jellebens/pomona/docs/sensors/level-sonic.md

# A02YYUW ultrasonic — tank level (Trello #270 / #283)

DFRobot SEN0311 (A02YYUW): a sealed ultrasonic distance sensor. Mounted
face-down above the reservoir, it measures the distance to the water surface;
the firmware turns that into litres. It is the **continuous** level gauge:
the CQRSENYW003 probe ([level-probe.md](level-probe.md)) stays the top-up
ladder and the pump interlock — nothing acts on the ultrasonic yet.

| | |
|---|---|
| Range | 30–4500 mm (blind below 30 mm: mount the face ≥ 3 cm above the FULL line) |
| Supply | 3.3–5 V — **use 3V3** (its TX swings to supply; the GIGA is not 5 V tolerant) |
| Output | UART 9600 8N1, frames `0xFF H L SUM`, distance = `H*256+L` mm, `SUM = (0xFF+H+L) & 0xFF` |
| Beam | ~ 40–60° cone: keep the tower column, the pump and the probe out of it |
| Firmware | `firmware/libraries/A02YYUW`, read in `src/sensors` since 2.4.0 |

## Wiring

| Sensor wire | GIGA |
|---|---|
| red (VCC) | **3V3** |
| black (GND) | GND |
| white (TX) | **D19 / RX1** (`Serial2`) |
| yellow (RX, mode) | **not connected** — floating = "processed value" output, the sensor streams on its own |

D0/D1 (`Serial1`) is not an option: the DS18B20 lives on D1. Don't confuse
the yellow wire with the DFR0523 pump pigtails ([../dosing/dfr0523.md](../dosing/dfr0523.md)).

## Bench check

After flashing, the tank tile shows the raw distance dimmed (`212mm`) and the
node publishes `ceres/pomona-0001/tele/water/level_distance_mm` every 30 s.
Hold a flat object at a measured distance: the value should agree to ±1 cm.
`--` on the tile = no valid frame for 3 s → check TX on D19 and 3V3/GND.

## Calibration (on the tower) — a measured fill table

The tank **tapers** (narrower at the bottom): a litre is ~12 mm of height near
the top and ~25 mm near the floor, so two points and a straight line are wrong.
Distance → litres is a table, `TANK_TABLE` in
`firmware/libraries/PomonaCalibration/src/PomonaCalibration.h`, interpolated
linearly between points and clamped at both ends (`libraries/A02YYUW/src/TankTable.h`).
The node publishes `level_pct` (of `TANK_FULL_L`) and `volume_l`, and the tile
shows litres, green ≥ 60 %, amber ≥ 30 %, red below.

To (re)measure it — after moving the sensor or changing the tank:

1. **Pump OFF** (`vertumnusctl.sh pomona-0001 pump off`) and keep it off. A
   Vertumnus restart puts it back on `auto`, so hold any ceres release meanwhile.
2. Drain the tank to a puddle; note the reading — that is 0 L.
3. Pour in **known volumes** — 0.5 L steps near the bottom, 1 L above — and
   after each wait for two equal `level_distance_mm` readings (≈ 1 min).
4. Put the pairs in `TANK_TABLE`, fullest first; set `TANK_FULL_L` to the
   volume you call full. Rebuild, roll out, put the pump back on `auto`.

**Only the sensor height changed?** Then the shape holds: read the distance at a
known volume and shift every point by the difference — that is how 2.4.2 got its table.

### Read between pump runs (2.4.6)

While the pump runs a litre or two is up in the tower and the surface is choppy (98–126 mm and
no-echo spikes at 9 L), and the tower drains back for minutes after a stop (8.74 L a minute after a
run, 9.0 L after half an hour). Since 2.4.6 the level is taken only once the pump has been off
5 min (`LEVEL_PUMP_SETTLE_MS`) and held through the next run (dropped after 45 min, then the live
reading): `level_distance_mm`, `level_pct` and `volume_l` are that value, `level_distance_live_mm`
is every sweep's raw median, `sys/health.level_held` says which. A dead sensor still reads absent
once the pump is off.

**Undone in 2.4.8 (2026-10-19).** The hold hid what the sensor saw: from 16 Oct ~23:30 it held
30 mm — the sensor's blind-zone floor, every frame `near`, zero good frames — for two and a half
days, through every pump run, and the reports showed a steady 9.00 L. The owner wants the real
readings, in the reports too. `level_distance_mm`, `level_pct` and `volume_l` are this sweep's
reading again, pump on or off; a run reads lower and choppier, and `tankJudge` still publishes no
litres for an unsteady surface. `level_distance_live_mm` stays (the same value) and
`sys/health.level_held` stays, always `false`, so no reader breaks.

### The table in force (2.4.10) — the sensor remounted 2026-10-19

The sensor was remounted with its two transducer bosses clear of the lid (they must not touch the
plastic). With exactly **10 L** in the tank it read **36 mm**, pump off and settled, on 2026-10-20.
Before that fill it read ~88 mm, and the owner had poured in "almost 4 L", so ~6.1 L = 88 mm.

- **10 L to 6.1 L:** a straight line between those two points, ~13 mm per litre. That matches the
  2026-10-09 fill near the top of the tapered tank.
- **Below 6.1 L:** the 2026-10-09 shape, shifted −33 mm. Verify it once with a known volume when
  the tank runs low.
- **Full is 10 L again**, 6 mm clear of the 30 mm floor (where 2.4.9 says `near`).

| L in tank | 0 | 0.5 | 1.0 | 1.5 | 2.0 | 2.5 | 3.0 | 3.5 | 4.0 | 4.5 | 5.5 | 6.1 | 7.0 | 8.0 | 9.0 | 10.0 |
|---|---|---|---|---|---|---|---|---|---|---|---|---|---|---|---|---|
| mm | 251 | 230 | 218 | 204 | 188 | 176 | 159 | 138 | 124 | 116 | 95 | 88 | 76 | 63 | 49 | 36 |

Since annona 0.12.0 (ceres ADR-0022) Ceres records the settled pump-off `volume_l` as the unit's
reservoir volume, so this table is now what the doses are sized for.

### The table of 2.4.5 — the sensor remounted 2026-10-16

New holes in the lid (two transducers 34.0 mm apart, M3 holes 72.6 mm apart: DFRobot's
drawing). Measured pump off with known volumes: 5.5 L = 110 mm, 7.5 L = 66, 8.0 L = 56,
9.0 L = 37 — a straight ~20 mm per litre. Below 5.5 L the 2026-10-09 shape, shifted −18 mm
(to be verified). 10 L would be inside the blind zone at this mount, so the top of the table is
**9.0 L**: do not fill above ~9 L, or raise the sensor.

| L in tank | 0 | 0.5 | 1.0 | 1.5 | 2.0 | 2.5 | 3.0 | 3.5 | 4.0 | 4.5 | 5.5 | 7.5 | 8.0 | 9.0 |
|---|---|---|---|---|---|---|---|---|---|---|---|---|---|---|
| mm | 266 | 245 | 233 | 219 | 203 | 191 | 174 | 153 | 139 | 131 | 110 | 66 | 56 | 37 |

The old mount's readings were wrong (87 mm at ~5 L — it heard something before the water), so
the 2.4.2 table below describes that mount only.

### The table of 2.4.2 — lid closed, the old mount

Full is **10 L at 76 mm** (a steady reading 2026-10-09 22:50–22:55, lid closed,
pump off) — 46 mm clear of the 30 mm blind zone. Annona's `reservoir_l` is 10.

| L in tank | 0 | 0.5 | 1.0 | 1.5 | 2.0 | 2.5 | 3.0 | 3.5 | 4.0 | 4.5 | 5.5 | 6.5 | 9.5 | 10 |
|---|---|---|---|---|---|---|---|---|---|---|---|---|---|---|
| mm | 284 | 263 | 251 | 237 | 221 | 209 | 192 | 171 | 157 | 149 | 128 | 116 | 82 | 76 |

**Read it with the pump off.** While the pump runs the sensor reads ~37–47 mm
at a full tank — the water falling back from the tower crosses the beam — so a
reading taken mid-cycle says "full" whatever the level.

### The fill it comes from — 2026-10-09 21:56–22:14 CEST, sensor 36 mm lower

| L in tank | 0 | 0.5 | 1.0 | 1.5 | 2.0 | 2.5 | 3.0 | 3.5 | 4.0 | 4.5 | 5.5 | 6.5 | 9.5 |
|---|---|---|---|---|---|---|---|---|---|---|---|---|---|
| mm | 248 | 227 | 215 | 201 | 185 | 173 | 156 | 135 | 121 | 113 | 92 | 80 | 46 |

6.5 → 9.5 L was a single 3 L pour, so the top of the curve is one straight
segment. 2.4.1 shipped this fill as is (full 9.5 L at 46 mm); with the lid
closed the face sits 36 mm higher.

## The blind zone and a silent sensor

Closer than 30 mm the sensor cannot measure. Since 2.4.2 a valid frame of
1–29 mm counts as 30 mm, i.e. **full** — the tank is never silent for being
too full. A frame of **0 mm** means "no echo" and stays invalid: that is what a
**tilted** sensor sends (2026-10-09 22:15–22:42: knocked during a pour, the
node published nothing). `sys/health.level_sonic_frames` tells the cases apart
remotely: `bad` climbing = no echo / garbage (tilted, obstructed), `near`
climbing = water at the face, nothing climbing = no frames (wiring, power).

**Since 2.4.9 the floor is not "full".** At the 2.4.5 mount FULL (9.0 L) is 37 mm, so a sensor
pinned at 30 mm — 2026-10-16..19, every frame `near`, zero good, two and a half days — passed as
`ok` and reported 9.00 L. A reading at the 30 mm floor (most of the window's frames in the blind
zone) is now `level_sonic_state` = `near`: `level_distance_mm` = 30, no litres.

## What is not the surface (2.4.3)

Since 2.4.3 a reading becomes litres only when it is plausibly the water surface and steady
(`tankJudge` in `TankTable.h`); otherwise the node publishes no `level_pct` / `volume_l` and says
why in `sys/health.level_sonic_state`:

| state | reading | what it was on the tower |
|---|---|---|
| `splash` | nearer than FULL (76 mm) by more than 15 mm, blind-zone frames included until 2.4.9 (now `near`) | the return water falling past the sensor during a pump run (33–53 mm, read as "10 L" by 2.4.2), foam |
| `no_echo` | farther than EMPTY (284 mm) by more than 15 + 5 = 20 mm | a **wet face** — condensation over 25 °C water after the move indoors read 240–720 mm (2.4.2: "0 L" for a day) |
| `unsteady` | the last 6 sweeps (30 s) disagree by more than 15 mm, or fewer than 6 yet | a face drying or wetting; the first 30 s after boot |
| `near` (2.4.9) | at the 30 mm blind-zone floor — most frames closer than the sensor can measure; checked first | 2026-10-16..19: every frame `near`, zero good, for 2.5 days — 2.4.8 and earlier called it `ok`, 9.00 L |
| `ok` | everything else; the table still clamps the last few mm at either end | with the pump running and a dry face: 86–87 mm = 9.06 L |

Keep the face dry and out of the return stream: mount it where nothing falls past it, give it a drip
edge, let the headspace breathe. The raw `level_distance_mm` is still published every cycle.

## The double echo

Over a flat surface the pulse can bounce water → sensor face → water and come
back at **twice the distance**: on the tower 320–355 mm for a 160–175 mm
surface, often enough to win a plain median (2.4.0 then read a well-filled tank
as nearly empty). Since 2.4.1 the driver drops every frame within 10 % of twice
another frame in its 15-frame window. Damping the mount helps too: a flat lid
right around the face reflects best — mount the face flush, or ring it with a
little foam or felt.
