jellebens/pomona/docs/seeding/README.md

# Seeding

Per-crop sowing and germination docs, plus the shared method. The 30-pod
target layout and nutrient targets live in
[../planting-plan.md](../planting-plan.md).

> **✅ Strawberry SOWN 2026-08-03 — 12 sponges, ~5 seeds each.** The full
> strawberry quantity went in, superseding the 3-sponge PoC allocation. See
> [strawberry.md](strawberry.md) for the as-built record and the dated
> timeline: germination 17 Aug – 2 Sept, 3-week count ≈24 Aug, transplant ≈14–28 Sept.
>
> **✅ BOTH CROPS GERMINATED 2026-08-07** — lettuce and strawberry, from an
> early-August sowing. The strawberries came up on **day 4** against a 14–30
> day book figure; the 28 °C ambient that looked like a problem accelerated
> them. See [lettuce.md](lettuce.md) and [strawberry.md](strawberry.md).
>
> **❌ The lettuce then DIED** (reported 2026-08-31, exact date unrecorded).
> First real failure in the project. Diagnose before re-sowing — and check the
> strawberries, which shared the tray and survived it: post-mortem in
> [lettuce.md](lettuce.md).
>
> **⏰ The strawberry transplant window is OPEN NOW** (≈31 Aug – 14 Sept;
> sown 08-03, so they are ~4 weeks old). Gate on the plants: roots through the
> sponge + 3–4 true leaves. They are the first crop into the tower; re-sown
> lettuce follows ~3 weeks after it goes back in.
>
> **⚠ Both deadlines are now due or past.** The reservoir must be dosed
> before anything is transplanted (EC 0.8–1.0, pH → ~6.0) — **pH-Down was
> deliberately deferred by the owner** on the #254 shopping list until the pen
> reads above 6.5, so check the pen before dosing rather than assuming a buy is
> needed. The **grow light was due end of August** and matters immediately:
> seedlings that raced up in a hot room stretch just as fast in weak light.
> [poc.md](poc.md) is superseded for strawberry; its hardware/software exit
> criteria now have an August deadline, not a September one.

## Per-crop docs

**All seed is bought and on hand** — nothing is waiting on a purchase.

| Crop | Doc | Sowing status |
|---|---|---|
| Strawberry (alpine 'Rote Baron Solemacher') | [strawberry.md](strawberry.md) | **✅ GERMINATED 2026-08-07** (day 4!) — sown 08-03, 12 sponges × ~5 seeds |
| Peppers (paprika, Dulce Italiano, chili) | _to write_ | **sow now — warm tray 25–28 °C** |
| Parsley | _to write_ | **soak seed now, sow a day later** — cool tray |
| Lettuce (iceberg) | [lettuce.md](lettuce.md) | **❌ DIED** (reported 2026-08-31) — diagnose, then re-sow into a clean tray |
| Basil | _to write_ | sow in ~1 week — fast, would outgrow the cohort |
| Dill | _to write_ | sow in ~1 week — fast, and hates root disturbance later |

Full sowing schedule with dates and spare counts: Trello #219, comment
"Seedling plan (2026-08-03)" + checklist "Seedling schedule".

## Per-crop sowing table

**All seed is now bought and on hand.** Sponge counts are overplanted so the
strongest can be thinned to the pod count in brackets.

| Crop | Sponges (→ pods) | Seeds/sponge | How to sow | Tray temp | Germination |
|---|---|---|---|---|---|
| Paprika | 4 → 3 | 2 | in the hole, ~5 mm deep | **25–28 °C** | 7–14 d |
| Dulce Italiano | 4 → 3 | 2 | in the hole, ~5 mm deep | **25–28 °C** | 7–14 d |
| Chili | 2 → 1 | 2 | in the hole, ~5 mm deep | **25–30 °C** | 7–21 d |
| Parsley | 4 → 3 | 3–4 | in the hole, shallow. **Soak seed 12–24 h first** | 18–24 °C | 14–28 d |
| Basil | 7 → 5 | 3–4 | shallow, barely covered | 20–25 °C | 5–10 d |
| Dill | 2 → 1 | 3–4 | shallow, barely covered | 15–21 °C | 10–14 d |
| Lettuce | 3 → 4 pods by succession | 2–3 | **surface or barely covered** — light-favoured | 15–20 °C, **poor above 24** | 2–7 d |
| Strawberry | 12 → 10 | ~5 | **surface, uncovered** — Lichtkeimer | 20–24 °C | 14–30 d |

Thin peppers and chili to the single strongest seedling per sponge; basil,
parsley and dill may keep 2–3 stems.

### ⚠ Two trays, not one — the temperatures do not overlap

Peppers want **25–28 °C** while lettuce fails above ~24 °C and strawberry
sits at 20–24 °C. One tray cannot serve both:

- **Warm tray (25–28 °C):** paprika, Dulce Italiano, chili. Top of the
  fridge, near a radiator, or a heat mat. These are buried seed, so this tray
  does *not* need light until they sprout — but it must not dry out.
- **Cool tray (20–22 °C, bright indirect light):** strawberry (already
  running), lettuce, parsley, later basil and dill. This is the tray that
  must never go dark.

Dill at 15–21 °C is the odd one out; the cool tray's lower end suits it well
enough.

### ⚠ Hot weather (ambient ≈28 °C) — what it helps and what it breaks

Recorded 2026-08-03, ambient **28 °C**. This is not a neutral condition:

**Helps.** The warm tray needs no heat mat at all — 28 °C sits right in the
pepper/chili band. Sow peppers on the worktop and be done.

**Breaks.** There is no cool tray at 28 °C ambient, and three things need one:

| Crop | Wants | At 28 °C |
|---|---|---|
| Lettuce | 15–20 °C, poor above 24 | Thermodormancy above ~27 °C in theory — **but this seed lot germinated fine at 28 °C on 2026-08-03.** Variety and lot dependent; test rather than assume. |
| Strawberry | 20–24 °C | Textbook says germination falls off above ~25 °C. **In practice this batch germinated on day 4 at 28 °C** — heat accelerated it. The remaining risk is total germination *rate* and stretched seedlings, not a stalled tray. |
| Dill | 15–21 °C | Too warm; patchy. |
| Parsley | 18–24 °C | Warm, and it is already the most erratic germinator in the plan. |
| Basil | 20–25 °C | Fine — basil is heat-tolerant and germinates fast at 25–28 °C. |

**What to do:**

1. **Move the strawberry tray to the coolest spot available** — cellar,
   north-facing room, tiled floor, lowest shelf. This matters most: 12
   sponges of slow seed are already committed. Check it is not near a sunny
   window; a domed tray in 28 °C ambient with sun on it can exceed 35 °C,
   which is lethal rather than merely slow.
2. **Ventilate daily, without fail.** Heat plus a sealed humid dome is ideal
   damping-off and algae weather.
3. **Dill: hold until it cools**, or fridge-prime the seed (soak 12–24 h,
   then 24–48 h in the fridge before sowing). *Lettuce turned out not to need
   this — it germinated at 28 °C anyway on 2026-08-03. Tolerance varies by
   variety and seed lot, so try a couple of sponges before assuming the heat
   will stop it.*
4. **Peppers and chili: sow now**, ambient is ideal.
5. If nothing cooler than ~26 °C exists in the house, accept slower and
   patchier strawberry germination and treat the fridge reserve seed as the
   real backup, re-sown when the weather breaks.

### Sowing order now that everything is on hand

- **Sow now:** peppers and chili — longest lead after strawberry, every week
  of delay pushes fruiting deeper into winter, and at 28 °C ambient they need
  no heat source.
- **Hold until it cools (or fridge-prime):** dill. Lettuce is already up —
  see [lettuce.md](lettuce.md) — and gets re-sown on succession every 2–3
  weeks from here.
- **Parsley:** soak the seed 12–24 h and sow into the coolest spot available,
  or hold it with the lettuce if nothing is below ~26 °C.
- **Sow in ~1 week:** basil. It germinates in 5–10 days (and is happy at
  28 °C), so sowing it alongside the peppers would leave it transplant-ready
  long before the rest of the cohort and leggy while it waits.

## Shared method — starter sponges

Starter medium is **grow sponges** for every crop (decided 2026-08-03).
Sponges are inert and pH-neutral, so unlike rockwool they need no acid
pre-conditioning — and their surface stays evenly damp, which is what
surface-sown light germinators need. Rockwool was considered and dropped:
it is alkaline (pH ~7.5–8, needs a pH 5.5 pre-soak), its top crusts dry, and
a wet lit rockwool surface algaes up.

**Sponge shape:** cross-cut into four wedges, gaping when dry and closing as
it swells when wet. Soak before sowing, then sow on the **wedge top faces**,
not down the slit — fine seed dropped into the cut is lost in the dark. The
same four wedges grip the seedling stem at transplant. See
[strawberry.md](strawberry.md) for the placement and pipette techniques.

1. **Prep:** dunk in plain demin water, squeeze under water a few times to
   expel air, let absorb fully, drain. No pH correction of the soak water.
2. **Damp, not saturated.** **2–3 mm of plain demin water** in the tray only,
   no nutrients yet; waterlogged sponges rot seed and invite damping-off.
3. **Sow** into the pre-made hole for normal seed — **except light
   germinators, which go on the surface uncovered** (see
   [strawberry.md](strawberry.md)).
4. **Dome for humidity, but do not use a dark cupboard.** Light germinators
   (strawberry, and lettuce prefers it) must have light on the seed from day
   one; only buried-seed crops are indifferent to it. Bright *indirect* light
   is the safe default for a shared tray — direct midday sun through glass
   cooks a domed tray.
5. Keep exposed sponge tops shaded once under light; permanently wet
   surfaces grow algae.
6. At first true leaves, tray-feed **quarter-strength A+B, pH ~5.8**. Demin
   water has no buffering, so the nutrient solution holds the pH.
7. **Transplant gate:** roots through the sponge + true leaves (2 for most
   crops, 3–4 for strawberry). Move the **whole sponge** into the net pod;
   it must not sit in standing water.

## Why slowest-first

The principle behind the order above: stagger sowing by germination speed so
the whole cohort reaches transplant size together, instead of the fast crops
going leggy in the tray while the slow ones are still bare sponge.

1. **Strawberry — ✅ done 2026-08-03** (12 sponges). 14–30 d germination,
   6–8 weeks to transplant size; slowest by a wide margin now that it is
   seed-grown rather than plugs, which is why it led.
2. **Peppers, chili, parsley: 7–28 d** — the longest lead after strawberry.
   Every week of delay pushes their fruiting further into winter.
3. **Basil, dill, lettuce: 2–14 d** — fastest, so they go last. Lettuce then
   turns over continuously; re-sow a couple of sponges every 2–3 weeks.

Dates key off the **actual strawberry sow date, 2026-08-03** (recorded on
Trello #219).

## Reservoir state gate

Nothing is transplanted while the reservoir holds plain demineralised water
(EC ~0, unbuffered). Dose A+B to **EC 0.8–1.0** for young transplants,
correct pH to **~6.0** with the PH-201H pen, then plant. Ramp to the shared
**EC 1.4–1.6** over 2–3 weeks as the fruiters go in.
