jellebens/pomona/docs/planting-plan.md

# Planting plan — 30-pod layout, nutrients, commissioning

Status: final. Crops and the 30-pod layout were owner-decided **2026-07-29**
(Trello #219), all-edible — the flower trial (chamomile, lavender) was cut
and the pods reallocated. Revised **2026-08-03**: **lettuce ×4 added (seed on
hand)**, trimming dill and chili by one pod each. Strawberry keeps its 10
pods.

**Tomato is out of the plan entirely (owner, 2026-08-03).** The tros (vine)
tomato added earlier that day was dropped, and with the cherry tomato already
replaced there is now **no tomato in the tower**. Its 2 pods went back to
basil and parsley. Reasons it went: indeterminate at 1.5–2 m with heavy
trusses, it would have shaded the tiers above and dominated reservoir draw in
a 25×25×86 cm tower on 10 L; it also demanded EC 2.0–3.0 against lettuce's
0.8–1.2 on a single shared reservoir. If tomato is ever wanted back, the
tower-appropriate choice is a **dwarf/determinate cherry** (Tiny Tim / Red
Robin) ×2 — seed would need buying — or better, a truss variety in its own
separate bucket with its own solution.

## ✅ AS-BUILT — first transplant, 2026-08-31

**18 of 30 pods planted.** The tower is live for the first time.

| Tier | Planned | **As-built** |
|---|---|---|
| 6 (top) | Dill ×1 · Basil ×2 · Strawberry ×2 | *empty* |
| 5 | Parsley ×3 · Lettuce ×2 | *empty* |
| 4 | Basil ×2 · Strawberry ×3 | **Strawberry ×4** |
| 3 | Strawberry ×5 | **Strawberry ×5** |
| 2 | Dulce Italiano ×3 · Chili ×1 · Lettuce ×1 | **Dulce Italiano ×3 · Chili ×2** |
| 1 (bottom) | Basil ×1 · Lettuce ×1 · Paprika ×3 | **Paprika ×4** |

**As-built totals (18):** strawberry 9 · paprika 4 · Dulce Italiano 3 · chili 2

**Deltas from plan:** paprika +1, chili +1, strawberry −1 (9 of 10 survived to
planting). Basil, parsley, dill and lettuce are **not in the tower** — the
lettuce died in the tray and the herbs were not sown in time. Tiers 5 and 6
stay empty for them.

The heavy-fruiter-low principle held: peppers occupy tiers 1–2, strawberries
sit mid-tower at picking height. Losing the tier-6 strawberries is no loss —
keeping all nine together on tiers 3–4 is tidier to net and to pick.

### ⚠ The EC plan changed the moment the peppers went in

Earlier guidance said to run **EC ~1.2 while the tower is strawberry-only**.
That no longer applies: it was never strawberry-only. Nine peppers and chilis
(which want ~1.8–2.4) went in beside nine strawberries (1.2–1.6) on day one,
so the tower is mixed from the start and the shared **1.4–1.6** compromise is
the right target.

**But not yet.** These are freshly transplanted young plants: start at
**EC 0.8–1.0, pH ~6.0** and ramp to 1.4–1.6 over the following 2–3 weeks as
they establish.

### Immediate follow-ups

- [ ] **Confirm the reservoir is actually dosed.** If it is still plain
      demineralised water, the plants are sitting at EC ~0 with no buffering
      and will stall. This is the first thing to check.
- [ ] **Blank off the 12 empty pods** with their plugs — cuts evaporation and
      keeps light off the water, which keeps algae down.
- [ ] **Check every strawberry crown sits proud** of its sponge and clear of
      any pebbles. A buried crown rots.
- [ ] **Confirm the drip reaches tiers 1–4.** A dry tier is easy to miss.
- [ ] **Pinch strawberry flowers for 2–3 weeks** to force root and crown
      growth. On the peppers, pinching the first king flower likewise helps
      them bulk up before fruiting.
- [ ] Shade from harsh direct sun for the first 2–3 days.
- [ ] **Capture sensor baselines** — the telemetry stack went live the same
      day (#222), so this is the natural moment to record what a freshly
      planted, freshly dosed tower reads.
- [ ] Sow basil, parsley and dill, and re-sow lettuce into a clean tray, for
      tiers 5 and 6.

## Layout

Hocomay tower, 6 tiers × 5 pods. Tier 1 = bottom.

| Tier | Pods |
|---|---|
| 6 (top) | Dill ×1 · Basil ×2 · Strawberry ×2 |
| 5 | Parsley ×3 · Lettuce ×2 |
| 4 | Basil ×2 · Strawberry ×3 |
| 3 | Strawberry ×5 |
| 2 | Dulce Italiano ×3 · Chili ×1 · Lettuce ×1 |
| 1 (bottom) | Basil ×1 · Lettuce ×1 · Paprika ×3 |

**Totals (30):** strawberry 10 · basil 5 · lettuce 4 · paprika 3 ·
Dulce Italiano 3 · parsley 3 · chili 1 · dill 1

The 2 pods freed by dropping the tomato went to **basil (4→5)** and
**parsley (2→3)** — the two highest-turnover kitchen herbs, both genuinely
cut-and-come-again. Chili and dill stay at 1 each on purpose: one plant of
either out-produces what a household gets through.

Strawberry placement (tier 3 ×5, tier 4 ×3, tier 6 ×2) is unchanged and
matches [seeding/strawberry.md](seeding/strawberry.md).

### Placement rationale

- **Heavy fruiters low (tiers 1–2):** paprika, Dulce Italiano and chili sit
  at the bottom for stability and can be staked from the floor. They will
  crowd sideways as they bulk up — prune/train outward.
- **Strawberries mid + top:** fruit cascades clear of the tower at picking
  height.
- **Cut-and-come-again herbs (tiers 4–5):** basil, parsley.
- **Tall/airy on top (tier 6):** dill needs the headroom.
- **No tomato.** With the tros variety dropped, nothing in the tower now
  exceeds ~40 cm except the dill, so no tier gets shaded out and no plant
  needs external staking or weekly side-shooting.
- **Lettuce is the turnover crop:** ~30–45 days pod-to-plate. Re-sow a
  couple of sponges every 2–3 weeks and the 4 lettuce pods rotate
  continuously.

## Nutrients — one shared reservoir

Single 10 L reservoir → one compromise mix for all crops:

- **EC: 1.4–1.6 mS/cm** — lowered from 1.6–1.8 now that the tomato is gone.
  The truss tomato was the only crop wanting 2.0–3.0 and it was dragging the
  compromise up against lettuce (0.8–1.2) and strawberry (1.2–1.6). Without
  it the heaviest feeders are the peppers (~1.8–2.4), so a **1.4–1.6** middle
  sits much closer to every crop's real optimum.
- **pH: 5.8–6.2, set point ~6.0**

~~While the tower is strawberry-only, run EC ~1.2.~~ **Void — the tower was
never strawberry-only.** Peppers and strawberries went in together on
2026-08-31, so 1.4–1.6 is the target from the start; see the as-built section
above for the establishment ramp (0.8–1.0 first, then up over 2–3 weeks).

Per-crop ideal hydro pH, all covered by the 5.8–6.2 window:

| Crop | Ideal pH |
|---|---|
| Strawberry (alpine) | 5.5–6.2 |
| Paprika / Dulce Italiano / chili | 5.8–6.3 |
| Basil / parsley / dill | 5.5–6.5 |
| Lettuce | 5.5–6.0 |

## Commissioning sequence

State 2026-07-27: reservoir holds **7.5 L plain demineralised water** — EC ~0,
unbuffered pH. Demin water is unbuffered, so pH readings before nutrients go
in are meaningless (they drift).

1. Add A+B nutrients (on hand). Target **EC 0.8–1.0** for the first young
   transplants, not the full 1.4–1.6 — that comes later as plants mature.
2. Measure pH with the PH-201H pen (nutrients buffer the water, readings now
   stable). Later the SEN0169-V2 probe provides continuous readings.
3. Correct toward pH 6.0 with pH-Down/Up (to buy).
4. Germinate seeds in starter sponges; transplant into pods once roots show
   through the sponge. See [seeding/](seeding/README.md).
5. Strawberries are **seed-grown alpines** ('Rote Baron Solemacher', on
   hand) — sown first because they are the slowest crop, and they make the
   grow light mandatory by mid-September. See
   [seeding/strawberry.md](seeding/strawberry.md).

## Seeding

Sowing and germination now live in **[seeding/](seeding/README.md)** — the
shared sponge method, sowing order, and per-crop docs. Start with
[seeding/strawberry.md](seeding/strawberry.md).

Full sowing schedule (two batches, spare counts, transplant gate) is on
Trello #219 — comment "Seedling plan (2026-08-03)" + checklist "Seedling
schedule".

## Seeds & supplies (shopping list, checklist lives on Trello #219)

- ~~Cherry tomato~~ / ~~tros tomato~~ — **no tomato in the plan**, nothing to
  buy or sow (owner dropped it 2026-08-03)
- ~~Salad~~ — **seed on hand**: lettuce, 4 plants (succession re-sow)
- ✅ Paprika — compact/snack mini bell, 3 plants
- ✅ Sweet pepper 'Dulce Italiano', 3 plants
- ✅ Chili — compact variety (Apache / rawit), 1 plant
- ~~Strawberry plugs~~ — **not needed, seed on hand**: alpine 'Rote Baron
  Solemacher' (*Fragaria vesca* var. *semperflorens*), 10 plants
- ✅ Basil — Genovese, 5 plants
- ✅ Parsley — flat-leaf (Gigante d'Italia), 3 plants
- ✅ Dill, 1 plant
- ✅ Starter medium: grow sponges (on hand)

**All seed is bought (2026-08-03) — nothing is waiting on a purchase.** The
remaining outstanding items are the #220 hardware ones below.
- Already tracked on #220: pH-Down/Up, EC cal fluid 1413 µS/cm, grow light,
  Fibaro plug

## Ops notes

- 7 fruiting plants on 10 L → expect near-daily top-ups once mature in
  summer; the water-level sensor (#220) makes this visible. Dropping the two
  truss tomatoes takes a real bite out of peak reservoir draw — they would
  have been the thirstiest plants in the tower by a wide margin.
- Top up with plain (demin) water between full nutrient changes; re-dose by
  EC reading.
- Lettuce at the shared EC 1.4–1.6 still risks some **tip burn** — harvest
  heads young and keep airflow over the tower. Less of a problem than at
  1.6–1.8, but the one-reservoir compromise has not vanished.
