jellebens/pomona/docs/seeding/strawberry.md

# Seeding — strawberry (alpine, 'Rote Baron Solemacher')

Status: active plan, 2026-08-03. Owner has **seed**, not plugs — this
supersedes the "buy day-neutral plugs" line in
[../planting-plan.md](../planting-plan.md).

## What the variety is, and why it matters

Packet: **Erdbeere 'Rote Baron Solemacher'** =
*Fragaria vesca* var. *semperflorens* — an **alpine / wild strawberry**
(German *Monatserdbeere*), not a garden strawberry. Consequences, all good
for a tower:

| Trait | Effect here |
|---|---|
| **Lichtkeimer** (light germinator) | Seed must lie **on** the surface — burying it stops germination. This is the single most important step below. |
| Germination needs **>20 °C** | Warm spot required; it is slow and erratic even then (~14–30 days). |
| **Runnerless** | No runners to dangle, root into neighbouring pods, or prune. Ideal in a 30-pod tower. |
| **Everbearing**, fruits in its **first year** | Unlike garden strawberry from seed (~a year to fruit), this cropped from summer to autumn in year one. |
| Compact, **15–20 cm** | Fits any tier; no staking. |
| Small, intensely aromatic fruit | Flavour is the payoff, not volume — expect a handful at a time across 10 plants, not bowls. |

Grows true from seed, so saving seed later is viable.

## Sowing

**Sow strawberries FIRST.** With plugs they would have been the instant
crop; from seed they are now the *slowest* thing in the plan, so they lead
rather than follow the pepper/basil batches.

### ✅ SOWN 2026-08-03 — 12 sponges, ~5 seeds each

**As-built, not a plan.** The owner sowed the **full main quantity — 12
sponges × ~5 seeds ≈ 60 seeds** — rather than the 3 sponges the PoC allotted.
The 5-sponge PoC ([poc.md](poc.md)) is therefore **superseded for strawberry**;
its hardware/software exit criteria still stand and now carry a real deadline
(see the timeline below), but the "prove it on 15 seeds first" hedge is spent.

What this changes:

- **No top-up wave is expected.** At ~5 seeds per sponge nearly every sponge
  yields a plant, so 12 sponges should comfortably fill the 10 pods with 2
  spares. Only re-sow if the 3-week count comes in low (below).
- **More seed is committed to one technique.** If the surface-sowing or the
  light/moisture regime is wrong, ~60 seeds are at risk instead of 15. The
  mitigation is the fridge reserve, below.
- **Sow 2 lettuce sponges now anyway.** Lettuce is up in 2–7 days versus
  14–30 for strawberry, so it is the early-warning signal on tray moisture,
  temperature and light — three weeks before the strawberries would reveal a
  problem. That is worth more now, not less, with 60 seeds committed.

### Reserve and the 3-week count

- **Put the rest of the packet in the fridge**, damp in a sealed bag. Cold
  stratification for 2–4 weeks costs nothing, lifts and evens out *F. vesca*
  germination, and is now the entire fallback if this sowing disappoints.
- **Count germinating sponges at ~3 weeks (≈24 Aug):**
  - **8 or more** → the 10 pods are covered. Keep the reserve seed for next
    season.
  - **4–7** → sow ~6 stratified sponges to top up.
  - **under 4** → something went wrong (surface dried out, seed fell into the
    cuts, too cold, too dark, mould). Diagnose before re-sowing — do not
    simply repeat it with the reserve.

**Only 10 pods are reserved for strawberry**, which is why 12 sponges is the
right number and 20 would have been waste: at ~5 seeds each, nearly every
sponge produces a plant.

Seed germinates patchily (40–60% is normal), which is why sponges are
overplanted rather than pods.

⚠ A deliberate later wave has a cost: sown three weeks behind, those plants
transplant three weeks deeper into the dark season and will likely wait until
spring to fruit. That is fine for insurance, but it is not a free succession
crop.

### Method — sponges, surface-sown

1. Soak the sponges in plain demin water, squeezing under water to expel
   air. Drain; **damp, not dripping**.
2. **Sow on the quadrant faces — avoid the hole and the cuts.** The sponge
   has a **small central hole with four cuts running radially out from it**,
   so the top is four quadrant faces around a little bore. The hole and cuts
   are for the seedling stem and its roots at transplant, *not* for sowing:
   dust-fine seed dropped in falls into the dark and will not germinate.

   Soak the sponge first — wet sponge swells and the cuts close up — then
   place each seed on a **quadrant face, ~5 mm out from the central hole**,
   and press it down with a fingertip just enough to make contact. Spread the
   4–6 seeds of a position across different quadrants. **Cover them with
   nothing at all** — they need light.

   *Placing seed this fine by hand is fiddly. Easiest method, using the 3 ml
   pipettes already on the shopping list: tip the seed into a few ml of
   water, stir, draw it up, and dispense one drop per spot. The drop carries
   the seed and leaves it sitting wet at the surface — standard practice for
   dust-fine light germinators. A damp toothpick works too, one seed at a
   time.*

3. **Never germinate this crop in the dark.** The instinct to put a seed tray
   in a warm dark cupboard is right for most seed and *wrong* here — a
   Lichtkeimer needs light on the seed to trigger germination at all. Dome or
   cover the tray (clear lid, bag, cling film) to hold humidity, but keep it
   in **bright indirect light**: a north/east windowsill, or beside a
   south-facing window rather than in its beam. Avoid direct midday sun
   through glass while domed — that cooks the tray.
4. Hold **20–24 °C** (20–22 °C if lettuce shares the tray). **2–3 mm of plain
   demin water in the tray** — no nutrients until the first true leaves.
   Never let the sponge tops dry out, since surface-sown seed has no moisture
   reserve.

   ⚠ **Too warm is a real failure mode, not just slower.** Above ~25 °C
   germination falls off; a domed tray in a hot room with sun on it can pass
   35 °C and cook the seed. Ambient was **28 °C** when this batch was sown
   (2026-08-03), so the tray belongs in the coolest spot available — cellar,
   north room, tiled floor — and must be ventilated daily against
   damping-off. See the hot weather section in
   [README.md](README.md).
5. Ventilate briefly each day to keep mould and damping-off away.
6. **Expect 14–30 days**, uneven. Do not give up on a tray at three weeks.

### After germination

- Seedlings start minuscule — two rounded seed leaves, and they stay tiny for
  a while even after a fast start. Patience is normal here, not a fault.
- **Vent the dome progressively, never all at once.** Alpine seedlings this
  small dry out within hours if the humidity drops off a cliff. Crack it open,
  widen the gap over several days, and only then remove it. This is the
  opposite of the lettuce, which wants the dome off promptly.
- **⚠ Damping-off is now the main risk**, not germination. Fast warm
  germination means a hot, humid, crowded tray full of hair-thin stems, which
  is exactly the condition that kills seedlings overnight at soil level. Daily
  ventilation is not optional, and standing water in the tray must stay at
  2–3 mm rather than creeping up.
- **Light matters more than it did an hour ago.** Seedlings that raced up in
  warmth will stretch just as fast in weak light, and a stretched alpine
  seedling stays weak. Brightest indirect spot available.
- At first true leaves, begin **A+B at quarter strength, EC 0.4–0.8, pH
  ~5.8**. Alpine seedlings burn easily; err lean.
- Thin to the single strongest seedling per position once they have 2 true
  leaves — scissors at the base, not fingers.

## Transplant into the tower

**Gate:** roots showing through the sponge **and** 3–4 true leaves. Normally
6–8 weeks from sowing, but germination ran ~10 days ahead of book, so the
window pulls back to **≈31 August – 14 September**. Gate on the plant, not the
date — a fast start does not guarantee the rest keeps pace.

1. Reservoir first: 7.5 L demin → A+B to **EC 0.8–1.0** (half strength for
   young plants) → measure with the PH-201H pen → pH-Down to **~6.0**.
   Never pot into plain demin water.
2. Transplant the **whole sponge** into the net pod — do not tease apart the
   roots.
3. **Crown above the medium.** Where leaf meets root must stay dry and in
   open air; a buried crown rots. Wedge with clay pebbles if the pod is
   loose.
4. Placement per the layout: **tier 3 ×5, tier 4 ×3, tier 6 ×2.**
5. Pinch off every flower for the first 2–3 weeks after transplant to force
   root and crown growth. It costs a few early berries and repays them.
6. Step EC up toward the shared **1.4–1.6** only once the peppers join
   (there is no tomato in the plan). While the tower is strawberry-only, run
   **~1.2** — alpines sulk at high EC.

## ⚠ The lettuce in this tray died (reported 2026-08-31)

These strawberries shared the tray and the conditions and have survived it —
which is reassuring but not proof of safety, since damping-off spreads. Treat
them as exposed: ventilate hard, strip out every dead seedling and any
mould or algae, replace the tray water, move to the coolest and brightest spot
available, and **check the stem bases daily rather than the leaves** —
damping-off shows at the base and kills within a day once it starts. Full
differential diagnosis in [lettuce.md](lettuce.md).

## Transplant day — runbook

Do these in order. Steps 1–3 happen **before a single plant is touched.**

### 1. Thin first, on the bench

One plant per pod. If a sponge still carries 2+ seedlings, snip the weaker
ones off **at the base with scissors** — pulling drags the keeper roots out
with them. Do this before transplanting, not after: two seedlings sharing one
net pod compete and both stay small.

Discard any sponge whose seedling is leggy and floppy rather than merely
small — a stretched alpine seedling does not recover, and it takes a pod that
a good one could have.

**How many stems to leave (owner decision, 2026-08-31):**

| Stems in the sponge | Do |
|---|---|
| **1** | Plant it as is. |
| **2** | Acceptable to leave. Alpines are small and runnerless, so a pod carries two better than a pepper would — but plan to snip one within 2–3 weeks once it is clear which established. |
| **3+** | **Thin now**, down to one or two. |

Leaving extras is not free. They share one pod worth of drip and root volume,
so both plants end up smaller and each yields less fruit; and the denser
foliage cuts airflow inside the tower, which is exactly the condition that
favours botrytis and damping-off — the most likely thing that killed the
lettuce.

**Better insurance than crowding a pod:** there are 12 sponges for 10 pods.
Keep the two extras going in the tray as replacements instead of doubling up
plants in a pod. A spare on the bench costs nothing; a crowded pod costs yield
all season.

Whatever the count, **snip at the base — never pull.**

### 2. Dose the reservoir — nothing goes in before this

Plain demin water is EC ~0 and unbuffered; roots stall in it.

1. 7.5 L demin → A+B to **EC 0.8–1.0** (half strength; these are young
   plants, and alpines burn easily).
2. Stir, let it settle, then read pH with the **PH-201H pen**.
3. Target **~6.0** (window 5.8–6.2). **pH-Down was deliberately deferred** on
   the #254 shopping list until the pen reads above 6.5 — so measure before
   assuming a correction is needed. If it does read high and there is no
   pH-Down in the house, that is a hard stop: transplanting into
   out-of-range solution is worse than waiting a day.
4. Cross-check the dosed reservoir against the in-tank EC/pH sensors while you
   are there. Transplant day is the natural moment to capture a baseline with
   known-good hand readings beside the live ones.

### 3. Prove the plumbing

Run the pump and confirm water actually reaches **the top tier**. A tier that
is not being dripped is easy to miss and fatal to whatever is planted in it.
Check every tier you intend to use.

### 4. Transplant

1. Move the **whole sponge** into the net pod. **The seedling never leaves the
   sponge** — do not pull it out, do not rinse it off, do not tease the roots
   apart. The sponge is now part of the plant and stays with it for life.
2. **Seat it, do not squeeze it.** A firm press to settle it home is fine;
   compressing or jamming it in is not. Squeezing collapses the sponge
   structure, drives the air out, and it then stays waterlogged — the same
   mistake as wringing one out by hand. Aim for snug.
   - **Sponge loose in the cup?** Pack clay pebbles around the outside to
     wedge it. Do not stuff extra sponge in beside it.
   - **Sponge too big?** Do not force it. Pare a sliver off the outside edge
     with a knife, well clear of the roots.
3. **Feed the roots down through the cup, not back up inside it.** Any roots
   already out of the sponge bottom go through the net slots so they hang free
   into the tower interior. Roots folded back up into the cup will circle and
   choke.
4. **Crown above the medium** — the point where leaf meets root must stay dry
   and in open air, proud of the sponge and clear of any pebbles. A buried
   crown rots, and this is the single most common way to kill a hydroponic
   strawberry.
5. Placement per the layout: **tier 3 ×5, tier 4 ×3, tier 6 ×2**. With fewer
   survivors, fill tier 3 first (best light, fruit hangs clear), then tier 4.
6. Blank off unused pods with their plugs — it cuts evaporation and keeps
   light off the water, which keeps algae down.

### 5. First week

- Keep them out of harsh direct sun for the first 2–3 days while roots take.
- Check daily that every planted tier is still being dripped.
- Top up with **plain demin water** as the level drops, then re-check EC —
  evaporation concentrates the solution, top-ups dilute it.
- **Pinch off every flower for the first 2–3 weeks.** It feels wrong and it is
  the highest-return thing you can do: it forces root and crown growth and
  pays back in far more fruit later.
- **EC:** start at 0.8–1.0 for freshly transplanted plants and ramp to the
  shared **1.4–1.6** over 2–3 weeks. (The old "hold ~1.2 while
  strawberry-only" advice is void — the peppers went in the same day.)

## Timeline — as-built

Sown **2026-08-03**. **✅ Germinated 2026-08-07 — day 4.**

That is dramatically ahead of the 14–30 day figure this doc predicted, and
worth understanding rather than just celebrating: the 28 °C ambient that the
hot-weather section flagged as a *problem* almost certainly caused it. Warmth
accelerates germination; the risk it carries is a lower total germination rate
and leggier seedlings, not a slower start. So the speed is real, but expect
the sponge count to matter (below) and watch for stretching.

| When | What |
|---|---|
| ~~17 Aug – 2 Sept~~ | ~~Germination window (14–30 d)~~ — **superseded, it germinated on day 4** |
| **now** | **Count sprouted sponges out of 12** — this replaces the ≈24 Aug 3-week count. 8+ → no top-up, keep the reserve seed. Under 4 → the fast warm germination came at the cost of rate; sow stratified reserve in a cooler spot. |
| **≈14–21 Aug** | First true leaves → start quarter-strength A+B (EC 0.4–0.8, pH ~5.8); thin to one seedling per sponge at 2 true leaves. |
| **by ≈25 Aug** | **pH-Down and EC calibration fluid must be in hand** — strawberry-driven now that the lettuce died. |
| **≈31 Aug – 14 Sept** | Transplant window, pulled ~2 weeks earlier by the fast germination (3–4 true leaves, roots through the sponge). Gate on the plant, not the date. |
| **by end Aug** | **Grow light running** — pulled forward from mid-Sept. Seedlings that came up on day 4 are growing *now*, in a hot room, and August daylight indoors is already marginal for stopping them stretching. |
| Sept onward | First flowers; pinch them for the first 2–3 weeks after transplant. |

### ⚠ Purchase deadline — pH-Down, ~14 August

The transplant gate requires a **dosed** reservoir: A+B to EC 0.8–1.0, then
pH corrected to ~6.0. **pH-Down/Up and the EC calibration fluid (1413 µS/cm)
are still unbought** (#220), and without pH-Down there is no way to bring a
freshly dosed reservoir to 6.0.

The binding date is set by the **lettuce**, which transplants first (see
[lettuce.md](lettuce.md)) — but the strawberries' fast germination has now
pulled their own window back to ≈31 Aug – 14 Sept, so both crops want the
reservoir live in the second half of August. **~14 August, and it is the most
time-critical item in the project.**

### ⚠ Light is on the critical path

These seedlings hit their growth phase in September–October as Belgian
daylight collapses, and they will try to flower into it. With plugs the grow
light (#220) was a nice-to-have; **from seed it is required.**

**The deadline moved forward to ~end of August.** It was mid-September, keyed
to a mid-September transplant. Two things changed it: germination ran ~10 days
early, so the plants are growing *now*, and they are doing it in a 28 °C room
where weak light produces stretched, permanently weak seedlings within days.
Waiting until the original date risks arriving with a tray of leggy plants and
no fruit until spring — the light is needed for the seedling phase, not just
for the tower.

Sources: [magicgardenseeds.de — Erdbeere 'Rote Baron Solemacher'](https://www.magicgardenseeds.de/Erdbeere-Rote-Baron-Solemacher-Fragaria-vesca-var-semperflorens-Samen),
[samenhaus.de — Monatserdbeeren Rügen Baron von Solemacher](https://www.samenhaus.de/monatserdbeeren-ruegen-baron-von-solemacher-erdbeersamen-von-buzzy-seeds/a-544686),
[gardenseedsmarket.com — Alpine strawberry 'Baron Solemacher'](https://gardenseedsmarket.com/alpine-strawberry-baron-solemacher-seeds-fragaria-vesca.html)
