jellebens/pomona/CHANGELOG.md

# Changelog

All notable changes to the Pomona project are documented here.
Format: [Keep a Changelog](https://keepachangelog.com/); versions are the
firmware semver from `firmware/libraries/PomonaVersion` (single source of
truth, bumped by the deploy scripts). Tags `v<version>` mark each release
merged to `master`.

## [2.4.0] - 2026-10-09

### Added
- the tank level from the A02YYUW ultrasonic (#270 / #283)
- the credential gate — check secrets.h against the running image before any build

### Other
- 2.4.0 — the tank level from the A02YYUW ultrasonic (#283); changelog

## [Unreleased]

## [2.4.10] - 2026-10-20

### Changed — the tank table for the remounted sensor (#283)
- The A02YYUW was remounted on 2026-10-19 with its two transducer bosses clear of the lid. The
  2.4.5 table no longer fit: with exactly 10 L in the tank it read 36 mm, which that table called
  9.0 L. The new `TANK_TABLE` comes from the owner's fill of 2026-10-20, pump off and settled:
  - before the fill, ~88 mm;
  - "almost 4 L" poured in;
  - then 10 L = 36 mm.
- Between 10 L and ~6.1 L the table is a straight line, ~13 mm per litre. That is what the
  2026-10-09 fill measured near the top, where the tank is widest. Below 6.1 L the 2026-10-09
  shape is shifted −33 mm to meet 88 mm.
- 10 L is FULL again, clear of the 30 mm blind-zone floor.
- Points (mm → L): 36→10, 49→9, 63→8, 76→7, 88→6.1, 95→5.5, 116→4.5, 124→4, 138→3.5, 159→3,
  176→2.5, 188→2, 204→1.5, 218→1, 230→0.5, 251→0.

## [2.4.9] - 2026-10-19

### Changed — a sensor pinned at its blind-zone floor says `near` (#283)
- A tank reading at or under the A02YYUW's 30 mm floor (the median of its frames; a frame inside
  the blind zone reads as 30 mm) is now judged `near` by `tankJudge`: `sys/health.level_sonic_state`
  = `near`, `level_distance_mm` still publishes the raw value, and no `level_pct` / `volume_l` —
  the same as `no_echo`. At the 2.4.5 mount FULL (9.0 L) is 37 mm, within the 15 mm splash margin
  of the floor, so a pinned sensor passed as `ok`: 2026-10-16..19 every frame was `near` (zero good)
  and the node reported 30 mm / 9.00 L for two and a half days. The tile shows `near`.

## [2.4.8] - 2026-10-19

### Changed — the tank level is live again (#283)
- Undoes 2.4.6's level hold. `level_distance_mm`, `level_pct` and `volume_l` are each sweep's
  reading again, pump on or off, so MQTT, Prometheus and the dashboards show what the sensor reads
  (owner: "I want to see the real readings also in the reports"). The hold had shown a steady
  30 mm / 9.00 L for two and a half days while every A02YYUW frame was `near` (the blind-zone floor,
  zero good frames). A pump run reads lower and choppier; `tankJudge` still publishes no litres for
  an unsteady surface. `level_distance_live_mm` (now the same value) and `sys/health.level_held`
  (always `false`) stay, so no reader breaks. The EC hold (2.4.4) is unchanged.

## [2.4.7] - 2026-10-16

### Changed — after a boot the pump runs first
- The duty cycle started in its OFF phase at every boot, so a reboot added a whole off spell
  (15 min in establishment, 45 by day / 105 at night established) to the downtime itself: two OTAs
  within 14 min on 2026-10-16 left the pump off from 13:58 to ~14:27. Every boot (an update, a power
  cut, a crash) now starts the cycle with a run (`PUMP_ON_MS`), then the normal off spell. The pump
  is still off through setup, and the level interlock and an operator override still take
  precedence. Erring wet is recoverable, erring dry is not. Credential gate passed against
  `build-2.4.6`.

## [2.4.6] - 2026-10-16

### Changed — the tank level is read between pump runs (#283)
- While the pump runs a litre or two is up in the tower and the surface is choppy (98–126 mm and
  no-echo spikes at 9 L), and it drains back for minutes after a stop (8.74 L a minute after a run,
  9.0 L after half an hour). The level (`level_distance_mm`, `level_pct`, `volume_l`) is now taken
  only once the pump has been off 5 min and held through the next run (the same hold as EC's,
  `src/sensors/ec_hold.h`; dropped after 45 min). A steady line that only falls as the plants drink.
- New `tele/water/level_distance_live_mm`: every sweep's raw median. `sys/health.level_held` says
  whether the level is a held value. Credential gate passed against `build-2.4.5`.

## [2.4.5] - 2026-10-16

### Changed — the tank table for the remounted sensor (#283)
- The old mount heard something before the water: a steady 87 mm (9.06 L on the 2.4.2 table)
  while the tank held a little more than 5 L. The sensor was remounted (new holes, DFRobot's
  34.0 / 72.6 mm pattern) and measured pump off with known volumes: 5.5 L = 110 mm, 7.5 L = 66,
  8.0 L = 56, 9.0 L = 37 (~20 mm per litre). The table's top is those points; below 5.5 L the
  2026-10-09 shape is kept, shifted −18 mm (to verify once at a known low volume). At this mount
  10 L would be inside the 30 mm blind zone, so 9.0 L is the top of the table ("9 L or more").
  Credential gate passed against `build-2.4.4`.

## [2.4.4] - 2026-10-16

### Changed — EC is read between pump runs (ceres ADR-0020)
- The EC probe reads the pump: with the pump running the un-isolated TDS board reads high
  (2026-10-06/07: 1.43 off → 1.81 on; 2026-10-15/16: 1.63 off → 1.96 on), the step within seconds
  of each switch; pH, behind its DFR0504 isolator, is unaffected. Ceres 0.28.0 refuses to act on
  an EC whose pump states disagree, so EC control had stopped (0.29.0 alerts `ec_untrusted`).
- Until the EC probe gets an isolator, `tele/water/ec_ms_cm` is measured only with the pump OFF
  for 2 min (`EC_PUMP_SETTLE_MS`) and that value is held through the run and the settle after it
  (`src/sensors/ec_hold.h`); a hold older than 45 min (`EC_HOLD_MAX_MS` — an override, a long mix)
  is dropped for the live reading, and the live reading is used until the first pump-off value
  after a boot. The screen shows the same value.
- New `tele/water/ec_live_ms_cm`: this sweep's reading, pump on or off — the pump's effect stays
  visible in the archive. `sys/health.ec_held` says whether the published EC is a held value.
- Host-tested on the 2026-10-15/16 pattern (15 min on at 1.95 / 15 off at 1.63): only 1.63 is
  published after the first pump-off spell. 752,404 B flash (38 %), 26 % RAM; credential gate passed
  against `build-2.4.3`.

## [2.4.3] - 2026-10-11

### Fixed — a tank reading is litres only when it is the water surface (#283)
- 2.4.2 clamped every distance to the fill table's ends, so readings the sensor could not mean became
  confident numbers. On the tower: the return water falling past the sensor during a pump run read
  33–53 mm → **"10 L"**; a wet face (condensation over 25 °C water since the tower moved indoors) read
  240–720 mm, jumping minute to minute → **"0 L" from 2026-10-10 ~15:00 for over a day**, while the tank
  held ~9 L (the owner's figure with the pump running; the dry sensor read 86–87 mm = 9.06 L).
- `tankJudge` (`TankTable.h`) now classifies each reading: **splash** (nearer than FULL by > 15 mm — the
  tank cannot fill past its full mark; this includes the blind-zone frames 2.4.2 read as full),
  **no_echo** (farther than EMPTY by > 20 mm — the floor is 284 mm away), **unsteady** (the last 6 sweeps,
  30 s, disagree by > 15 mm, or fewer than 6 yet), else **ok**. Only `ok` publishes `level_pct` /
  `volume_l`; the raw `level_distance_mm` is still published always (calibration aid).
- `sys/health` gains `level_sonic_state` (`ok|splash|no_echo|unsteady|absent|uncalibrated`);
  `level_sonic_calibrated` now means "the fill table is set" (2.4.2: table set AND sensor answering).
  The screen's tank tile shows the state word instead of a litre figure it cannot vouch for.
- Host-tested against the tower's own readings (87 mm → ok 9.06 L; 38 → splash; 30 → splash;
  391/651 → no_echo; jumping 120 → unsteady). 752,140 B flash (38 %), 26 % RAM; credential gate passed
  against `build-2.4.2`.

## [2.4.2] - 2026-10-09

### Fixed — the tank table for the lid-closed mount; the blind zone reads full; frame counters (#283)
- 2.4.1's table was read with the sensor lower than its final place. With the lid closed, 10 L reads a steady
  76 mm (pump off), so the table is shifted +36 mm (shape unchanged: 10 L at 76 mm … 0 L at 284 mm, 14 points)
  and **full is 10 L** again — 46 mm clear of the 30 mm blind zone. `UNIT_RESERVOIR_L` back to 10.
- Known: while the pump runs the sensor reads ~37–47 mm at a full tank (the return water crosses the beam), i.e.
  "full" mid-cycle; read the level with the pump off. Not filtered yet.
- **The blind zone reads as full** instead of going silent: a valid frame of 1–29 mm counts as 30 mm (→ 10 L,
  100 %). A frame of 0 mm stays "no echo" — what a tilted sensor sends — so a knocked sensor never reads full.
  On 2026-10-09 22:15–22:42 the sensor sat tilted after the last pour and the node published nothing.
- `sys/health` gains `level_sonic_frames: {good, near, bad}`, the driver's counters since boot, so a silent
  sensor's cause shows remotely: `bad` climbing = garbage / no echo (tilted), `near` = water at the face, none
  climbing = no frames at all (wiring, power).
- Fixed in the driver on the way: a valid "no echo" frame's checksum byte is 0xFF, which the resync took for a
  new header and lost the next frame; resync now only follows a checksum failure.

## [2.4.1] - 2026-10-09

### Changed — the tank level in litres from a measured fill table; double echoes dropped (#283)
- The tank **tapers**, so the two-point line of 2.4.0 is replaced by a distance → litres table measured on the
  tower on 2026-10-09 (0 L at 248 mm … 9.5 L at 46 mm, 13 points): `TANK_TABLE` / `TANK_FULL_L` in
  `PomonaCalibration.h`, interpolated linearly and clamped (`libraries/A02YYUW/src/TankTable.h`).
  `TANK_DIST_FULL_MM` / `TANK_DIST_EMPTY_MM` are gone. The node now publishes `level_pct` and `volume_l`.
- **Full is 9.5 L** (10 L would sit ~40 mm from the face, near the 30 mm blind zone): `level_pct` is a share of
  9.5 L and `UNIT_RESERVOIR_L` in `sys/meta` is 9.5 (Annona's `reservoir_l` was set to 9.5 the same night).
- **Double echo:** the sensor often reported twice the true distance (320–355 mm over a 160–175 mm surface — the
  pulse bouncing water → face → water), enough to win the median. The driver now drops every frame within 10 %
  (min 10 mm) of twice another frame in its window, and the window grows from 7 to 15 frames (~2–3 s) so a
  direct frame is there to unmask them.
- Host-tested: an echo-dominated window (6 echoes, 3 direct) reads the water; the table's points, midpoints and
  clamps. `docs/sensors/level-sonic.md`: the fill-table procedure, the recorded table, the echo.

## [2.4.0] - 2026-10-09

### Added — the tank level from the A02YYUW ultrasonic (#270 / #283)
- New library `firmware/libraries/A02YYUW`: a non-blocking parser of the sensor's 9600-baud
  `0xFF H L SUM` frames (checksum, 30–4500 mm range, resync after a bad frame) that reports the
  median of the last 7 good frames, or -1 after 3 s without one. `sensorsPoll()` drains the UART every
  `loop()`; the sensor is on `Serial2` (TX → D19), powered from 3V3, its RX wire floating.
- Calibration `TANK_DIST_FULL_MM` / `TANK_DIST_EMPTY_MM` in `PomonaCalibration.h` (NAN until read on
  the tower — procedure in `docs/sensors/level-sonic.md`). Volume is linear between the two.
- MQTT: `tele/water/level_distance_mm` always when the sensor answers; once calibrated
  `tele/water/level_pct` (now the ultrasonic's — the Grove strip only fills it when no calibrated
  ultrasonic exists) and `tele/water/volume_l`. `sys/health` gains `level_sonic` and
  `level_sonic_calibrated`; `sys/meta.sensors` lists `level_sonic`.
- Screen: the tank tile is live — litres, green from 60 %, amber from 30 %, red below; before
  calibration the raw distance (`212mm`, dimmed) so the calibration session can read it off the tower.
- The level probe still drives the pump interlock; nothing acts on the ultrasonic yet.
- Ceres: vertumnus 0.27.0 subscribes the three topics and exports them as `ceres_reading{metric}`.

### Added — the credential gate of the release flow
- `.claude/scripts/check-secrets.sh <running.bin> [secrets.h]`: checks that `WIFI_PASS` and
  `MQTT_PASS` from `secrets.h` are embedded in the binary of the image the node runs now — the
  passwords it last connected with. Prints only "matches" / "NOT in" and the length, never a value;
  exit 0 = build, 1 = mismatch or placeholder, 2 = cannot check. The `pomona-release` runbook makes
  it Phase 3, step 0 (a failure is a STOP: the owner supplies the right `secrets.h`), and says to
  keep `~/ota-tools/build-<ver>/` of every flashed image as the next gate's reference.
- Why: 2.3.2 (2026-10-09) was built from a stale `secrets.h`; the node flashed, then the broker
  refused it, and with the OTA trigger MQTT-only no corrected image could reach it — recovery took a
  power cycle and an owner-approved broker password change. The gate fails that build
  (against `build-2.3.1`: exit 1).

## [2.3.2] - 2026-10-09

### Fixed — NTP is retried until it answers
- The photoperiod needs wall-clock time, and the node asked NTP once at connect and
  then every 6 h — **also after a failed attempt**. With no clock the light is held
  off (the safe failure), so one lost packet at boot meant up to 6 h of a dark tower.
  It happened on 2026-10-09: the tower was moved indoors, rebooted twice
  (12:41 and 12:56 CEST), missed its one attempt and held the light off from
  12:41 — the 6 h retry would have come at ~19:00, an hour before lights-out.
- A failed attempt is now retried after `NTP_RETRY_MS` (60 s), alternating
  `NTP_HOST` (`pool.ntp.org`) and `NTP_HOST_FALLBACK` (`time.cloudflare.com`), until
  one answers; the 6 h resync applies only after a success. Each attempt stays
  bounded by `NTP_TIMEOUT_MS` (1.2 s), well inside the 30 s watchdog. The pump never
  consulted the clock and still does not.
- Compiles clean for `arduino:mbed_giga:giga`: 750,340 B flash (38 %), 138,848 B RAM (26 %).

## [2.3.1] - 2026-09-17 (on the tower since 2026-09-17 01:12; released to `master` with 2.3.2)

### Changed — the node bounds one request, not the day (owner 2026-09-16, ceres card #315)
- `DOSE_MAX_ML_PER_CMD` pH-Down 2.0 → 4.0 ml (`config.h`); a regular dose is
  about 2 ml, so one command can carry a double. A/B stay at 10 ml.
- The rolling 24 h budget is gone: `DOSE_MAX_ML_PER_24H`, the per-channel dose
  ring and the `over 24h cap` refusal are removed (`dosing.cpp`), and `sys/meta`
  no longer announces `max_ml_per_24h`. How much goes in per day is the
  controller's decision — Ceres removed its own daily cap on 2026-09-11 (ADR-0004).
- Why: 2.3.0 carried the retired playbook caps ("twice Ceres's derived acid
  cap"), so from the moment it went live (2026-09-15 17:01) the node refused every
  2.7 ml and 4.8 ml request with `over per-command cap 2.0 ml` and the tank
  drifted to pH 8.5 in a day. The Vertumnus side (reading `max_ml_per_cmd` from
  `sys/meta`, its gitops rail lowered to 4.0 ml) is ceres card #315.
- Still enforced per request: the reagent must be known and calibrated, one
  channel at a time, the absolute 60 s run cap, the 10 s bench cap.

### Added — `firmware/tools/lzss_ota.py`, the `.ota` packager
- Compresses an exported `.bin` the way the library's `LZSSDecoder` expects
  (Okumura LZSS, EI 11 / EJ 4, space-filled window) and writes the Portenta
  OTA header (length, CRC-32, magic `0x23410266`, version word). With `--ref`
  it validates itself against a previously served image first: the 2.3.0 image
  decodes to a 758,392 B binary and re-encodes to the identical 604,590 B
  payload. Recipe in `firmware/pomona/README.md` ("Building the `.ota` image").

## [2.3.0] - 2026-09-15

### Changed — the home screen (PR #102)
- Six tiles in two rows of three replace the nine-tile grid: water temp, EC and pH
  on top; air temp, humidity and a dimmed "tank level" placeholder below. Pressure,
  lux, the Grove level % and the probe status word leave the screen (still published
  on MQTT; the probe still drives the pump interlock). The placeholder waits for the
  continuous level sensor (#270 / #283). Unused `setInt()` removed so the build stays
  warning-free. Compiles clean for `arduino:mbed_giga:giga` (arduino-cli 1.5.1):
  750,468 B flash (38 %), 139,872 B RAM (26 %). Not flashed: the 2.x line (2.0.0 →
  2.3.0) goes to the tower together, in the maintenance window of ceres card #295 item 7.

## [2.2.0] - 2026-09-13

### Added — the ack echoes the request's trace context
- A `dose/request` may carry a W3C `traceparent` (Vertumnus 0.13.0 puts it in
  while a trace is live). Every `dose/result` for that request — a refusal at
  request time or the `done` when the run ends — echoes the value unchanged, so
  one Jaeger trace spans decision → broker → node → ack → judgement (ceres
  ADR-0008 addendum). Opaque string, never parsed; requests without it produce
  the 2.1.0 acks byte for byte. The event buffer grows 224 → 320 bytes so an ack
  with the 55-char value never truncates.

## [2.1.0] - 2026-09-12

### Changed — the topic root is `ceres/`
- Demeter is Ceres (ceres ADR-0012: one pantheon, Roman only). Every v2 topic
  is `ceres/pomona-0001/…`; the controller is Vertumnus (`vertumnus-pomona-0001`),
  the config service Annona. Nothing else changes; 2.0.0 was never on the tower.

## [2.0.0] - 2026-09-12

### Changed — BREAKING: the v2 wire (demeter ADR-0008)
- Every topic moves to `demeter/pomona-0001/…`: `tele/<zone>/<metric>`
  (+ `tele/node/rssi_dbm|uptime_s`), `sys/status` (LWT), `sys/health`,
  `sys/diag/i2c_scan[/get]`, `sys/ota/url|result`, `actuator/pump/state|reason`,
  `actuator/light/state`, `actuator/pump/set`, `desired`. The unit connects as
  its own broker user `unit-pomona-0001` (client id the same). `docs/mqtt.md`
  rewritten; the v1 tree is history the archive keeps.
- `sys/meta` (retained, on connect): the node's self-description — type,
  node, fw_version, contract 2, sensors, actuators, reservoir_l, and every
  doser's calibration + caps.

### Added
- **The #224 dosing contract:** `dose/request` `{id, reagent, ml, rate}` is
  converted with the node's OWN calibration (`PomonaCalibration.h` `DOSER_CAL`)
  and checked against the node's OWN rails (`config.h`: per-command ml caps,
  rolling 24 h ml caps, one channel at a time, 60 s absolute run cap); every
  request is acked on `dose/result` `{id, status: done|refused|failed, ml, ms,
  channel, reason, ts}`. A bench run (USB Serial `dose chN …` only — the MQTT
  bench topic is gone) acks without an id.
- `actuator/light/set` (`auto|on|off`): a human override of the photoperiod
  (#263 wanted it for testability); resets to `auto` at boot.
- `desired.stage` replaces `control/mode` as the establishment/established
  switch (Demeter's registry publishes the document).
- A tiny flat-JSON reader (`src/util/json.h`) for the two documents the node reads.

### Docs
- `docs/mqtt.md` is the node's view of ADR-0008; `docs/control-architecture.md`
  topic names; the sketch README.

## [1.3.8] - 2026-09-10

### Fixed
- pH recalibration post-Cat5e - anchors 1.529/2.074 V

### Docs
- v1.3.7 release notes (automated)

## [1.3.7] - 2026-09-10

### Fixed
- EC recalibration post-Cat5e - K 0.9745 -> 0.7692

### Docs
- v1.3.6 release notes (automated)

## [1.3.6] - 2026-09-10

### Fixed
- EC signal on A2 per perm wiring (was A0)

### Docs
- 2026-09-09 recalibration on final wiring + tube runs
- v1.3.5 release notes (automated)

## [1.3.5] - 2026-09-09

### Fixed
- pin map as-landed by owner - ch1 pH=D6, ch2 A=D4, ch3 B=D5
- move pump signals back to bench-proven D4-D7 block

### Docs
- v1.3.4 release notes (automated)

## [1.3.4] - 2026-09-09

### Fixed
- pH-Down = D13, spare = D12 — verified at the panel

### Docs
- v1.3.3 release notes (automated)

### Other
- v1.3.4

## [1.3.3] - 2026-09-09

### Added
- OTA screen force-awake + tagged serial logs

### Fixed
- ch1 pH-Down = D12, spare = D13 (owner correction)

### Docs
- ch3 slow-speed constant 0.20 ml/s (#286)
- ch2 + ch3 commissioned and calibrated (#285, #286)
- DFR0523 as-built — ch1 commissioned + calibrated (#284)
- v1.3.2 release notes (automated)

### Other
- v1.3.3
- OneWire moves to D1 (perm wiring)
- final wiring pin map — ch1 D13, ch2 D10, ch3 D11, ch4 D12

## [1.3.2] - 2026-09-04

### Added
- serial debug commands for the bench session

### Fixed
- use DFRobot GravityPump reference pulse values

### Docs
- v1.3.1 release notes (automated)

### Other
- v1.3.2

## [1.3.1] - 2026-09-03

### Fixed
- generate PPM with mbed PwmOut — Servo lib holds the pin high on GIGA

### Docs
- v1.3.0 release notes (automated)

### Other
- v1.3.1

## [1.3.0] - 2026-09-03

### Added
- bench-test module for the DFR0523 channels (#284)

### Docs
- v1.2.0 release notes (automated)

### Other
- v1.3.0

## [1.2.0] - 2026-09-03

### Added
- band color coding on all metric tiles
- water level tile follows the 2026-09-01 level semantics

### Other
- v1.2.0
- auto-update CHANGELOG.md on every release tag

## [1.1.0] - 2026-08-31

The #260 control feature: the GIGA becomes the thing that decides when the
pump and light run, publishing its decisions as requests that Home Assistant
relays onto the Fibaro plugs. Delivered over the air the same evening
(compile 728 KB / 37%, OTA verified: `fw_version 1.1.0`, first requests
published with reason `boot_safe` → `schedule`). Until the HA-side cutover
switch (`input_boolean.pomona_firmware_control`) is turned on, the firmware's
requests are advisory only and HA's own schedule keeps driving the plugs.

### Added
- **Local pump + light control module (#260)** — duty cycle on `millis()`
  alone (15/15 establishment, 15/45 established day, 15/105 established
  night), so a unit with no network still waters correctly; NTP photoperiod
  (08:00–20:00 establishment, 06:00–20:00 established) with lights held OFF
  when there is no clock (off is the safe failure); level interlock with the
  5-min settle check, hourly rate limit, 24 h confirmed-low inhibit, and
  fail-open on unknown. Priority: interlock → override → schedule — an
  override can never outrun the interlock's veto.
- **Control topics** — retained QoS 1 `pomona/pump/request`,
  `pomona/light/request`, `pomona/pump/reason`, republished on every
  connect; subscribes `pomona/pump/override` + `pomona/control/mode`.
  Decisions publish on change, not on the 30 s metric cadence.
- `controlInit()` runs first in `setup()` — a rebooting unit reaches a known
  pump/light intent before anything that can hang.

### Docs
- Control architecture decision (where the logic lives) + `docs/mqtt.md`
  control-topic contract; level-probe mount is permanent (raw 0 mid-cycle
  is not trustworthy); planting-plan as-built (first transplant, 18/30
  pods); seeding notes (pod seating, stems per pod); lettuce post-mortem
  and transplant runbook.

## [1.0.0] - 2026-08-28

Assembly week's finale: the tower unit is built (#254) and **every v1
sensor is connected, reading, and calibrated** — water temp, EC, pH,
level probe, air (BME280), and light (BH1750) — with v1.0.0 itself
delivered over the air. Versions 0.1.13 → 1.0.0 were built and deployed
one at a time during the bench sessions (one commit per deployed version).

### Added
- **Remote I²C diagnostics** — retained `pomona/unit/i2c_scan` each
  publish cycle plus an on-demand trigger (`pomona/unit/i2c_scan/get`),
  so a headless unit's wiring is checkable over MQTT.
- **Boot screen** — name, version, build date, live I²C scan result, and
  a step-by-step boot progression (sensors → I²C → WiFi → MQTT). Tap the
  Pomona header any time for the same info screen with a fresh scan.
- **OTA progress screen** — stages (downloading/decompressing/installing/
  rebooting), a live countdown, and a *do not power off* warning; failed
  updates show their reason, then restore the readings.
- **Water level tile as OK / WRN / CRIT** (≥3 / 1–2 / 0 probe points, in
  green/amber/red).
- Raw pH voltage published (`pomona/water/ph_raw_v`) — recalibration is
  doable remotely from now on.

### Fixed
- **Same-version OTA replay guard** — the broker replays queued `ota_url`
  messages on reconnect; a URL naming the running version is now skipped
  (a stale trigger once kept re-installing 0.1.13 in a loop).
- **Wedged-I²C-bus boot-loop immunity** — a miswired run holding SDA/SCL
  low made the scans outlive the watchdog; stuck pins are now detected
  before first I²C use, skipped, and named on the boot screen.
- Full-screen views no longer inherit the tiles' flex layout (clipped
  titles, unreachable tap-to-return on the info and update screens).
- Sensor availability flags drop honestly when a flaky cable kills reads
  after a good init (no more stale `bme280: true`).
- BME280 accepted at 0x76 **or** 0x77 — the unstrapped default is fine
  now that the Grove level strip (which owned 0x77) is retired.

### Calibrated
- **EC**: `EC_CAL_K = 0.9745` — stable 1.45 mS/cm in 1413 µS/cm fluid at
  25.6 °C (20 ml in a narrow vessel suffices; ~8 min settle).
- **pH**: two-point 1.56 V @ 7.00 / 2.10 V @ 4.00 (slope −5.56 pH/V),
  **validated** against the 10.01 buffer (read 1.00 V vs 1.02 V
  predicted). Buffer anchors are configurable constants; the probe's
  wet-up drift lesson is recorded in `docs/sensors/ph.md`.

## [0.1.12] - 2026-08-27

OTA release — over-the-air updates work end-to-end and untethered:
v0.1.11 (wired serial watch) and v0.1.12 (no cable at all, owner-confirmed
on screen) were both delivered via MQTT trigger → HTTP download →
bootloader apply. The unit no longer needs USB for firmware updates.

### Fixed
- **OTA download size verification + retry** (#243, PR #35) — the mbed
  core's `download()` returns the HTTP Content-Length while its file writes
  go unchecked, so a truncated file surfaced later as
  `decompress failed (-5)`. The OTA module now stats the stored file,
  compares it to the reported size and deletes + retries
  (`OTA_DOWNLOAD_ATTEMPTS`, config.h). A deterministic 4096-byte result
  indicates a corrupted OTA-partition FAT — reformat via QSPIFormat
  (runbook in the sketch README, including restoring the WiFi firmware if
  partition 1 is accidentally erased).
- **OTA watchdog starvation — the root cause** (#243, PR #36) —
  Arduino_Portenta_OTA only feeds the watchdog if `setFeedWatchdogFunc`
  callbacks are registered; without them the 1–2 minute decompress starved
  the 30 s IWDG, silently resetting the device mid-apply (and those
  mid-write resets were what corrupted the FAT). Callbacks are now
  registered for both the OTA stages and the WiFi download path.

### Changed
- MQTT status icon on the screen now uses the envelope symbol (PR #34).

### Infrastructure
- `pomona` EMQX user granted least-privilege ACLs (`allow pomona/#`,
  runtime; git DR mirror tracked separately) — without them the broker
  silently dropped all unit publishes and rejected the OTA subscription.
- QSPI flash partitioned on the bench unit (partition 2 = OTA). The
  bootloader shipped on the board applies OTA images fine — no bootloader
  update was needed.
- Known wart: retained `pomona/unit/ota_result` still reads
  `applying <url>` after a successful update — cross-check
  `pomona/unit/fw_version`; success reporting is a future #243 slice.

## [0.1.4] - 2026-08-26

First full monitoring release — the unit runs end-to-end: WiFi → MQTT →
publishing, with the touchscreen UI. Bench-verified all-green.

### Added
- **`firmware/pomona` v1 monitoring app** (#229, PR #28) — from-scratch modular
  sketch (entry point `pomona.ino`): WiFi + MQTT with backoff reconnect and
  LWT, publishing all v1 sensor readings to the cluster EMQX broker
  (`mqtt.lab.local:1883`, topics `pomona/<zone>/<metric>` — see
  `docs/mqtt.md`); LVGL current-readings screen on the GIGA Display Shield
  with the firmware version bottom-right; boot banner with version + build
  date; 30 s hardware watchdog; graceful absent-sensor handling (publishes
  what is readable plus retained availability JSON).
- **Screen blanking** (#248) — backlight off after a configurable idle
  timeout (`DISPLAY_BLANK_TIMEOUT_MS`, default 60 s); touch wakes the screen
  without activating UI elements; everything else keeps running while blanked.
- **WiFi/MQTT status icons** (#229 follow-up) — live red/green indicators on
  the screen for WiFi and MQTT connection state.
- **Basic OTA slice** (#243) — MQTT-triggered `Arduino_Portenta_OTA` fetch
  via `pomona/unit/ota_url`. (The planned IDE network-port upload is not
  possible on the GIGA — no mbed-H7 ArduinoOTA backend. Runtime OTA still
  requires the one-time USB prereqs: bootloader update + QSPIFormat, tracked
  on #243.)
- **`firmware/deploy.sh`** — Linux/WSL twin of `deploy.ps1` (same version
  auto-bump semantics).
- **WiFi failure diagnostics** — firmware version + numeric status per
  attempt, 3 begin-attempts per cycle, and a post-failure scan that reports
  whether the SSID is visible (this pinpointed both bench issues: SSID not
  broadcast on 2.4 GHz, then a WPA3-only/passphrase refusal).
- `PomonaCalibration` shared library (calibration constants used by both the
  app and the bringup sketch).

### Changed
- **Firmware restructured into module folders** (#251, PR #29) —
  `firmware/pomona/src/{display,network,sensors,ota}/`; `pomona.ino` and
  `config.h` stay at the sketch root. Byte-identical compile (pure refactor).
- **Config/secrets split** (#251) — non-secret settings (`WIFI_SSID`,
  `MQTT_HOST`, `MQTT_PORT`, `MQTT_USER`) live in `config.h`; `secrets.h` is
  passwords-only (`WIFI_PASS`, `MQTT_PASS`), `SECRET_` prefixes dropped.
- Absent-sensor re-probes rate-limited to 60 s (was every 5 s log spam).

### Infrastructure
- `pomona` MQTT user created in EMQX (broker denies anonymous).
- Bench: AP now broadcasts the 2.4 GHz SSID `B3ns-2-4` (GIGA radio is
  2.4 GHz-only) with WPA2 enabled.

## [0.1.0] - 2026-08-26

### Added
- Firmware version infrastructure (#243, PR #27) — `PomonaVersion` library as
  the semver single source of truth, printed in every sketch's boot banner;
  `firmware/deploy.ps1` compiles with arduino-cli, flashes over USB (COM6)
  and auto-bumps the version each deploy (patch by default).

## Pre-versioning (2026-07 → 2026-08)

- Bench bring-up of the v1 sensors (#242): wiring, per-sensor docs under
  `docs/sensors/`, level-probe calibration ladder, DS18B20 ice-bath
  verification, GIGA pinout references.
- OTA + secure-secrets design (#243/#244): `docs/ota-and-secrets.md`
  (layered plan toward the ATECC608A secure element), gitignored `secrets.h`
  convention + `secrets.h.example`.
- `firmware/bringup` sketch (#220, PR #12): first sensor readings on the GIGA.
- Growing side: seeding PoC and sowing records (`docs/`), plan v4 (30 pods,
  sponges, EC 1.4–1.6).
