jellebens/pomona/docs/images/giga-r1-wifi-full-pinout.pdf

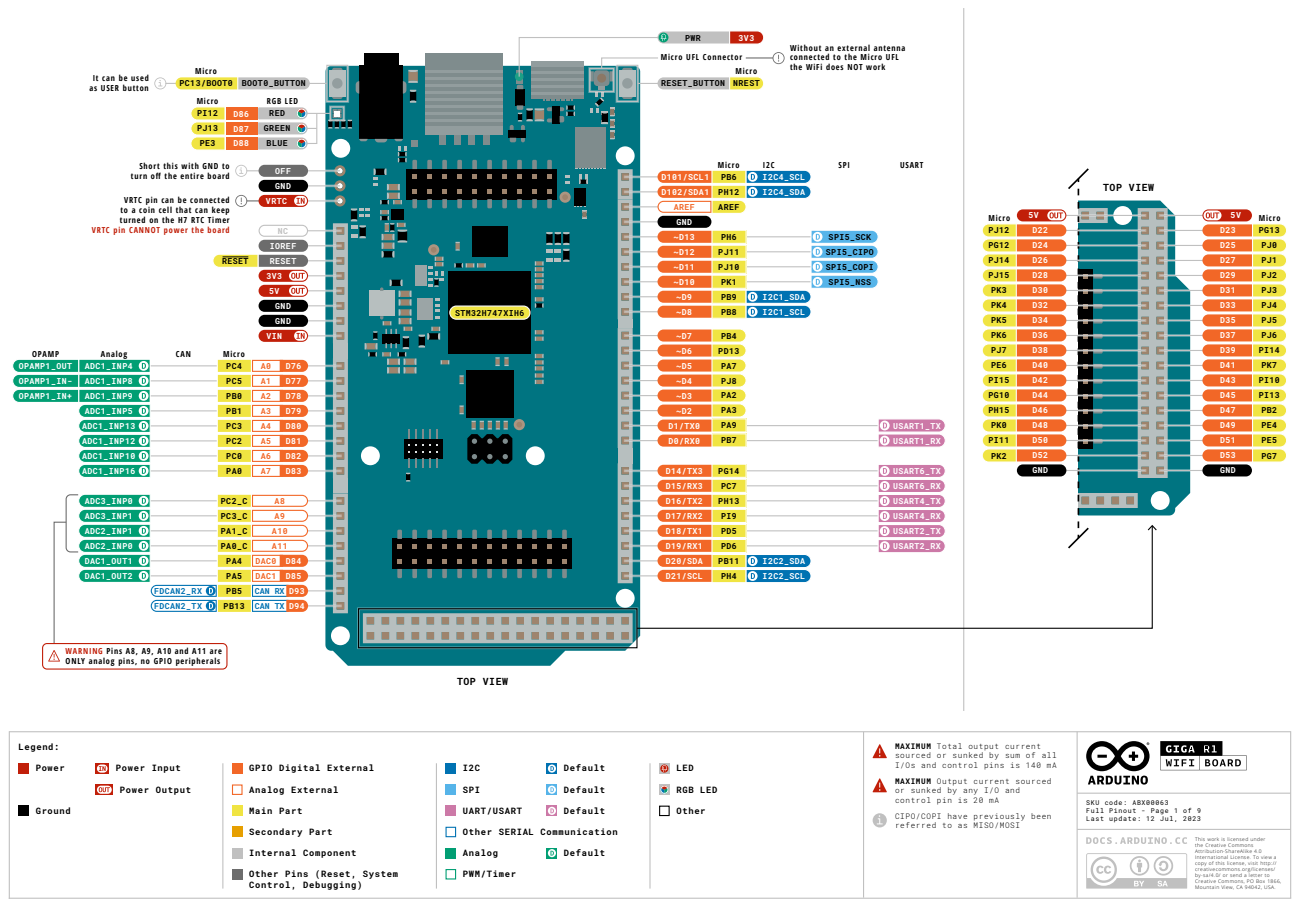
[picture p2: page 1]

Without an external antenna
connected to the Micro UFL
the WiFi does NOT work

It can be used
as USER button

Short this with GND to
turn off the entire board

VRTC pin can be connected
to a coin cell that can keep
turned on the H7 RTC Timer
VRTC pin CANNOT power the board

PB5
PB13

WARNING Pins A8, A9, A10 and A11 are
ONLY analog pins, no GPIO peripherals

MAXIMUM Total output current
sourced or sunked by sum of all
I/Os and control pins is 140 mA
MAXIMUM Output current sourced
or sunked by any I/O and
control pin is 20 mA
referred to as MISO/MOSI

GPIO Digital External
Analog External
Main Part
Secondary Part
Internal Component
Other Pins (Reset, System
Control, Debugging)

This work is licensed under
the Creative Commons
Attribution-ShareAlike 4.0
International License. To view a
copy of this license, visit http://
creativecommons.org/licenses/
by-sa/4.0/ or send a letter to
Creative Commons, PO Box 1866,
Mountain View, CA 94042, USA.

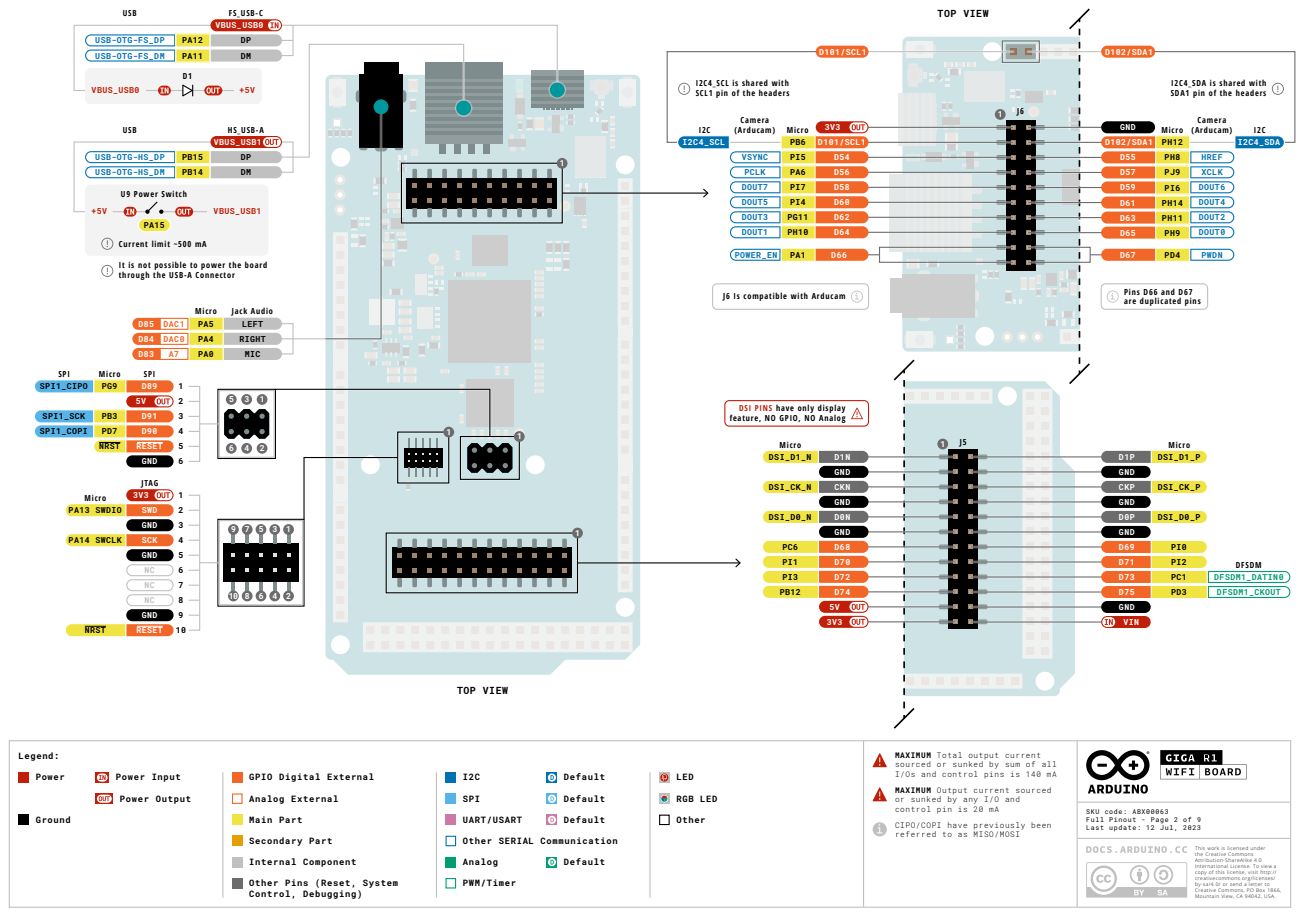
[picture p3: page 2]

I2C4_SCL is shared with
SCL1 pin of the headers

I2C4_SDA is shared with
SDA1 pin of the headers

It is not possible to power the board
through the USB-A Connector

PA5
PA4

DSI PINS have only display
feature, NO GPIO, NO Analog

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

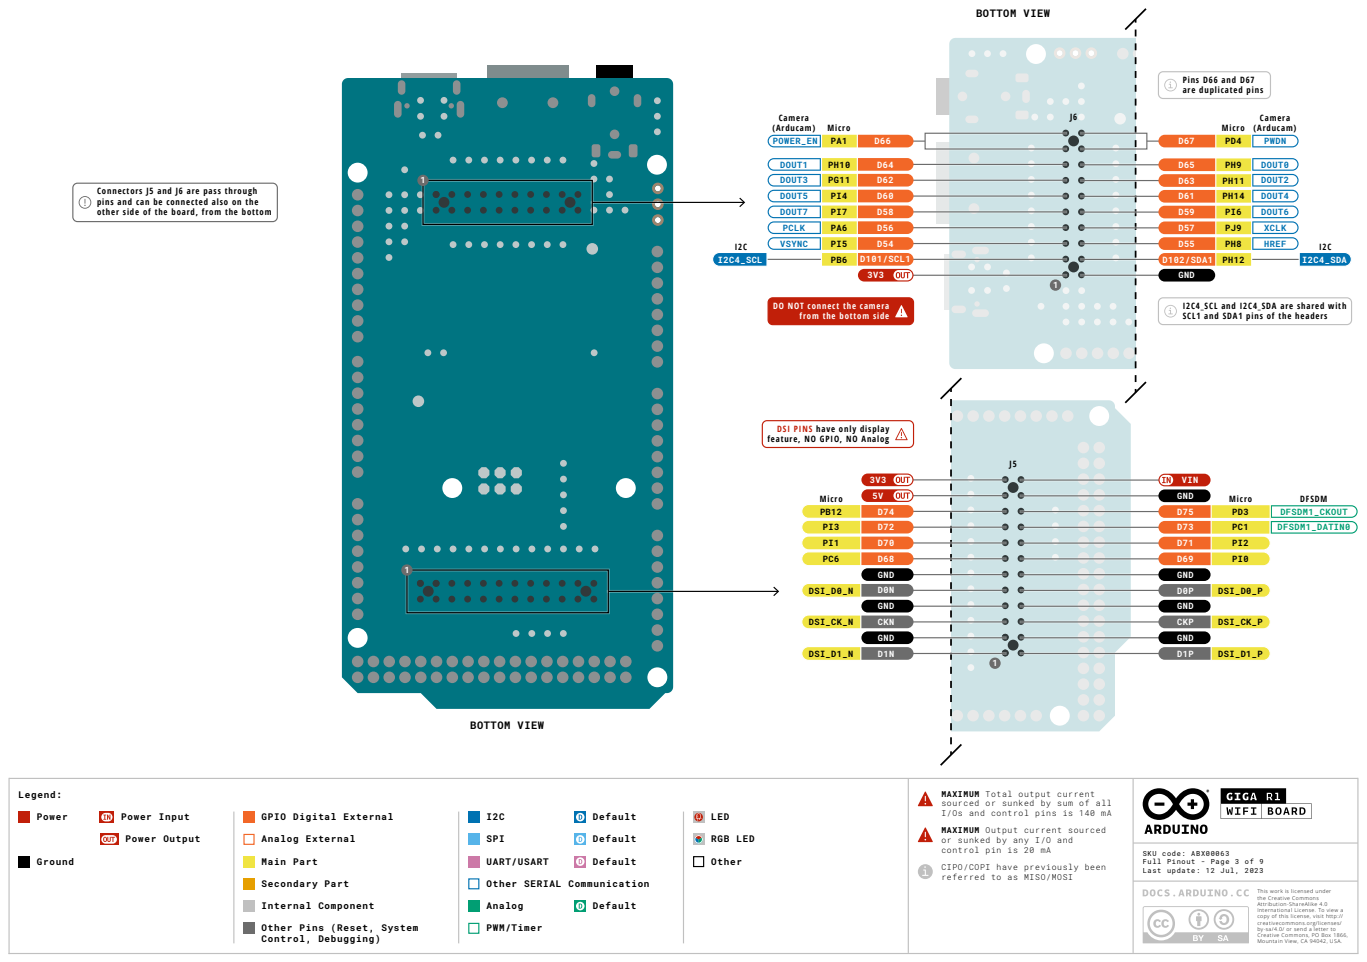
[picture p4: page 3]

Connectors J5 and J6 are pass through
pins and can be connected also on the
other side of the board, from the bottom

DO NOT connect the camera
from the bottom side

I2C4_SCL and I2C4_SDA are shared with
SCL1 and SDA1 pins of the headers

DSI PINS have only display
feature, NO GPIO, NO Analog

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

# WARNING!

# Advanced Section

# The following information is for advanced use only and may not be officially supported by Arduino software

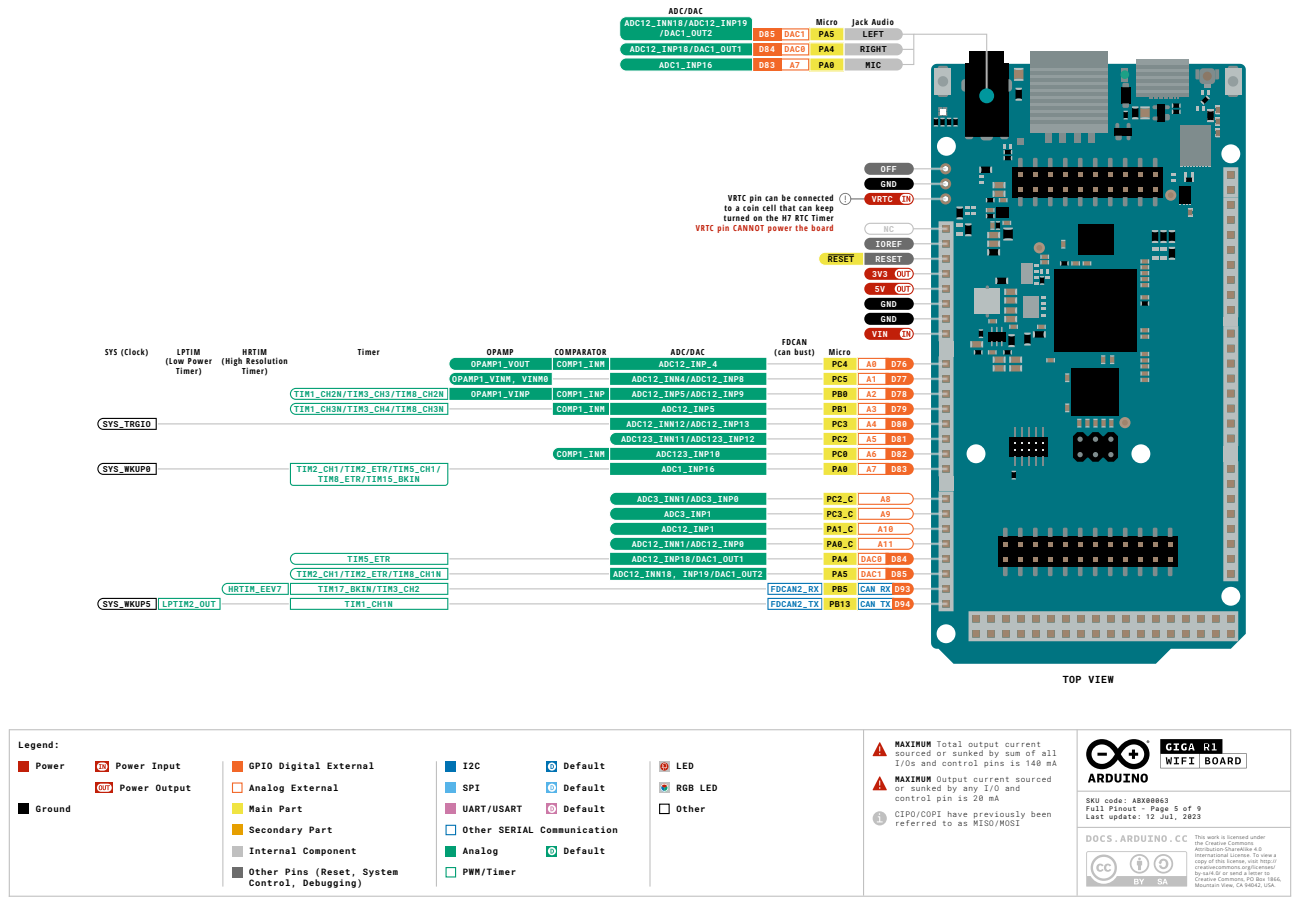
[picture p5: page 5]

PA5
PA4

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

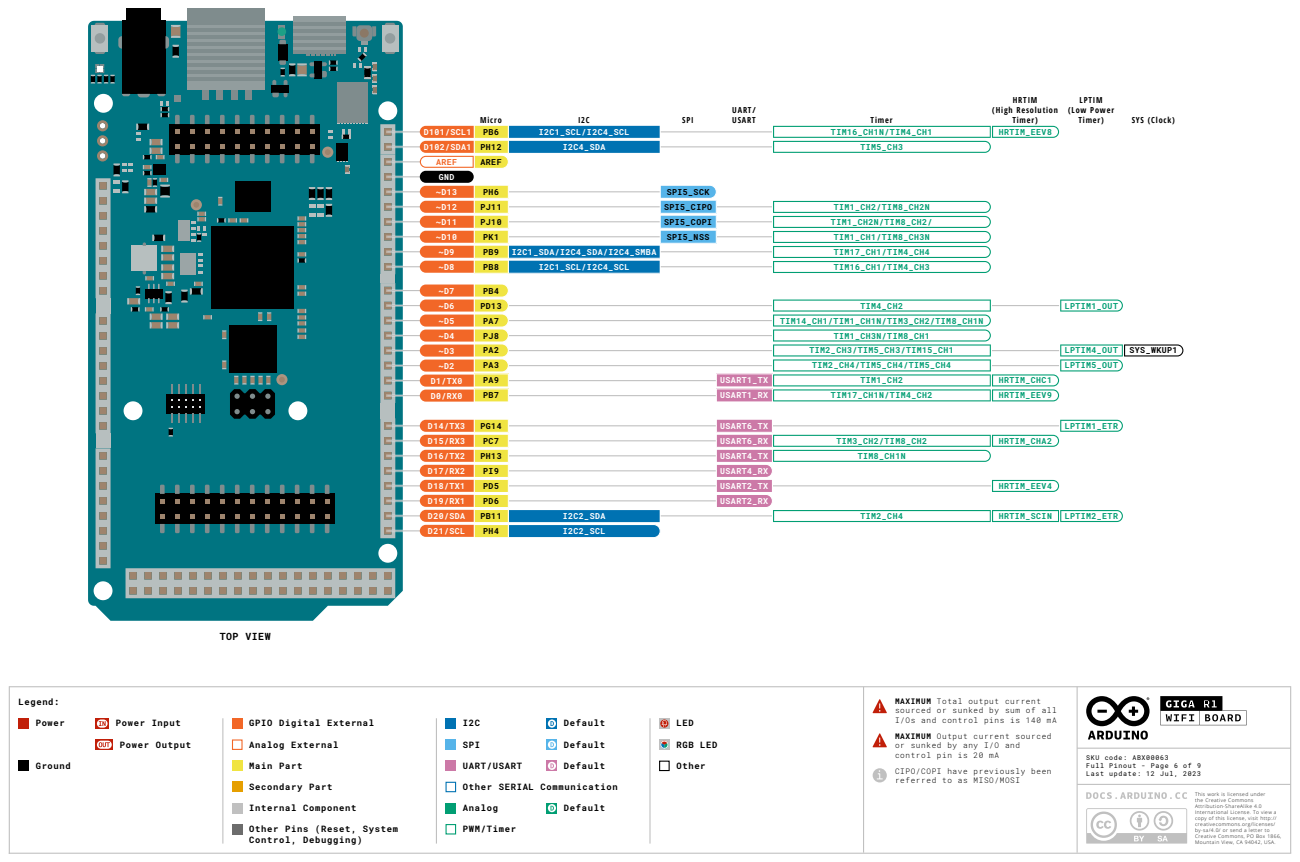
[picture p6: page 6]
SKU code: ABX00063; Full Pinout - Page 6 of 9 CIPO/COPI have previously been; Last update: 12 Jul, 2023; Legend:; Power; Power Input; Power Output; Ground; Default; SPI; UART/USART; LED; RGB LED; Other; TOP VIEW; TIM16_CH1N/TIM4_CH1 TIM5_CH3; TIM1_CH2/TIM8_CH2N TIM1_CH2N/TIM8_CH2/ TIM1_CH1/TIM8_CH3N TIM17_CH1/TIM4_CH4 TIM16_CH1/TIM4_CH3; TIM4_CH2; TIM1_CH3N/TIM8_CH1; TIM14_CH1/TIM1_CH1N/TIM3_CH2/TIM8_CH1N; TIM2_CH3/TIM5_CH3/TIM15_CH1 TIM2_CH4/TIM5_CH4/TIM5_CH4 TIM1_CH2 TIM17_CH1N/TIM4_CH2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

PB9 | I2C1_SDA/I2C4_SDA/I2C4_SMBA
PB8 | I2C1_SCL/I2C4_SCL

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

GPIO Digital External
Analog External
Main Part
Secondary Part

Other SERIAL Communication

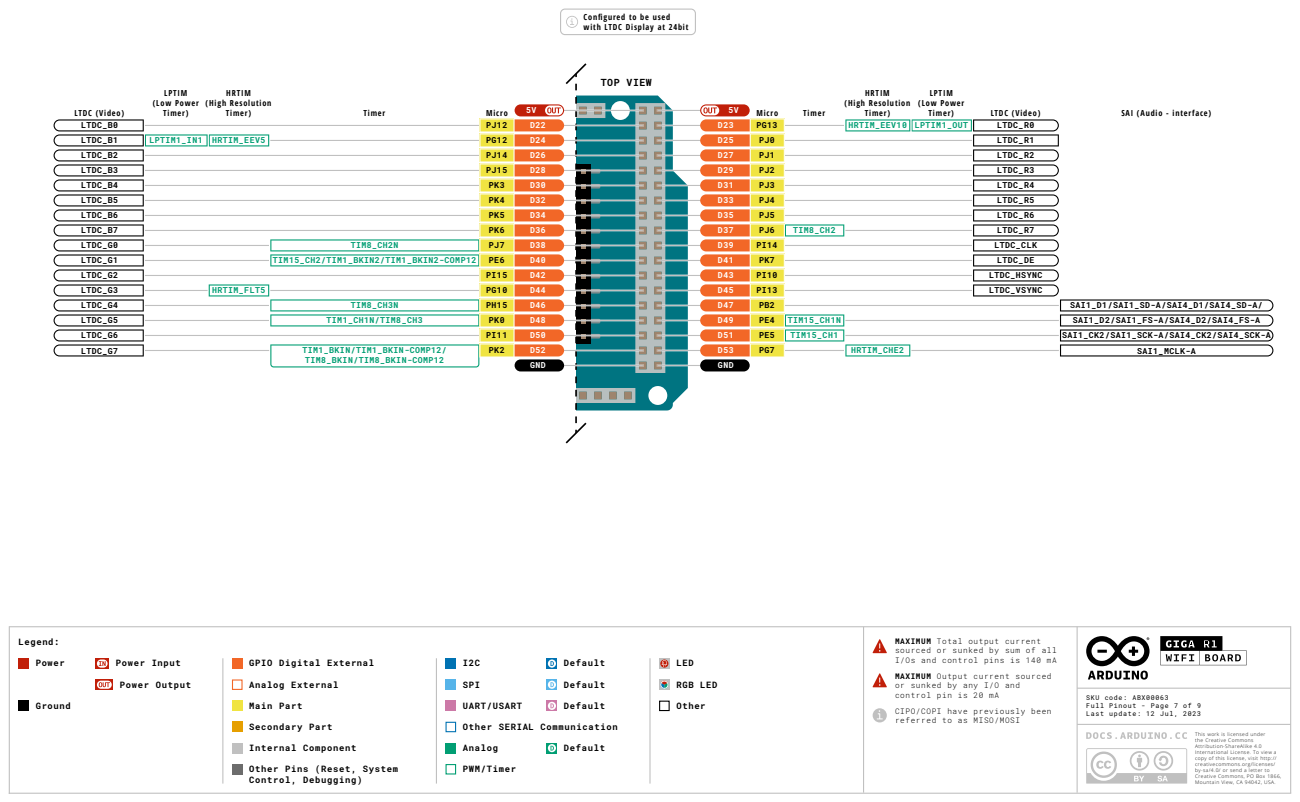
[picture p7: page 7]

Configured to be used
with LTDC Display at 24bit

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

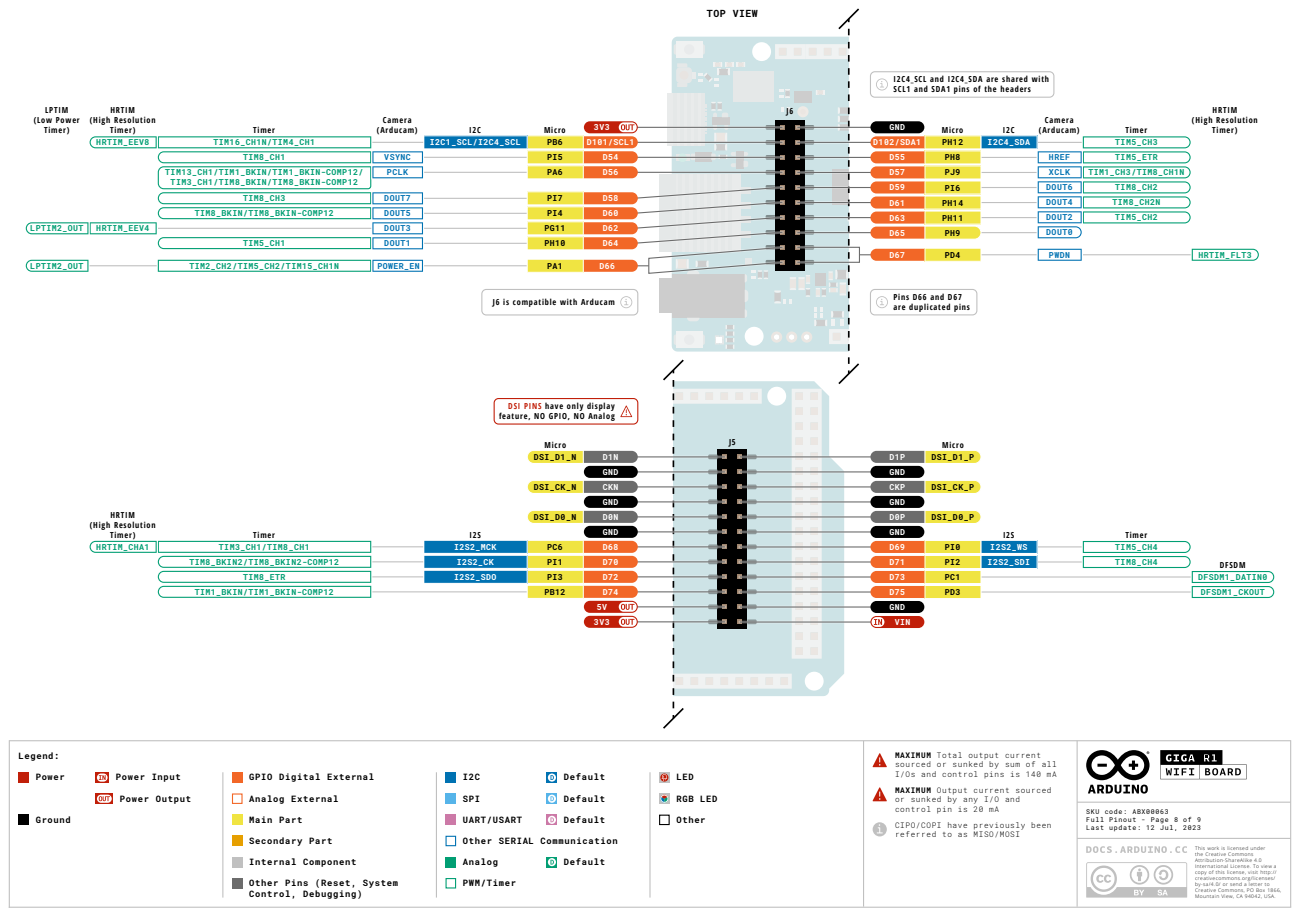
[picture p8: page 8]

I2C4_SCL and I2C4_SDA are shared with
SCL1 and SDA1 pins of the headers

J6 is compatible with Arducam

DSI PINS have only display
feature, NO GPIO, NO Analog

I2S2_CK
I2S2_SDO

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

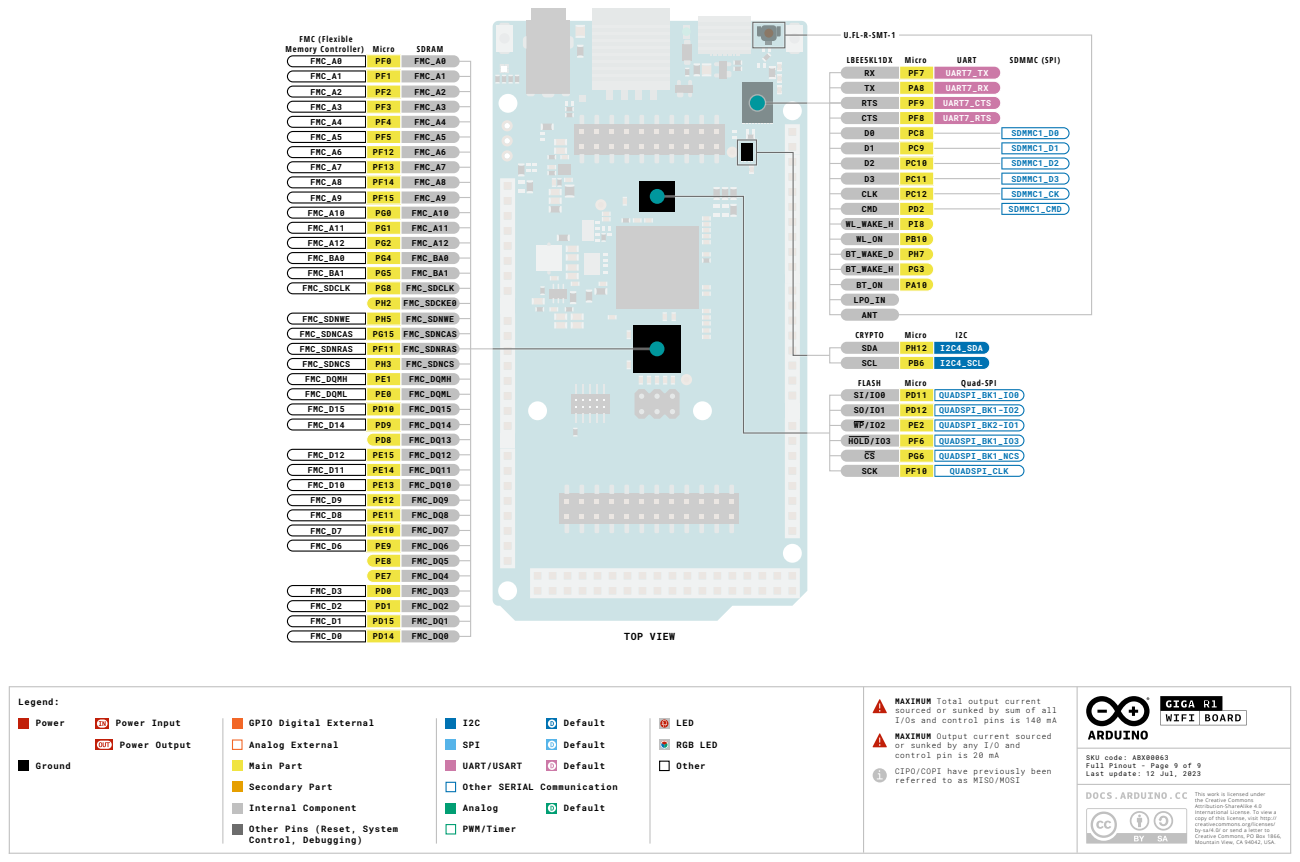
[picture p9: page 9]
SKU code: ABX00063; Full Pinout - Page 9 of 9 CIPO/COPI have previously been; Last update: 12 Jul, 2023; Legend:; Power; Power Input; Power Output; Ground; Default; SPI; UART/USART; LED; RGB LED; Other; TOP VIEW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

GPIO Digital External
Analog External
Main Part
Secondary Part

Other SERIAL Communication
