jellebens/pomona/firmware/pomona/src/network/network.cpp

// Pomona firmware — network module implementation (Trello #229; v2 wire #295).
//
// Broker + topic schema: docs/mqtt.md — since 2.0.0 the v2 contract
// ceres/<unit_id>/… of the ceres repo's ADR-0008 (EMQX mqtt.lab.local:1883).
// Credentials come from secrets.h (gitignored, Layer 1 of
// docs/ota-and-secrets.md); #244 moves them into the ATECC608A.

#include "network.h"
#include "../../config.h"
#include "../control/control.h" // publish what the unit decided (#260)
#include "../dosing/dosing.h"   // the ml-based dose/request contract (#224, #295)
#include "../ota/ota.h"
#include "../display/display.h" // OTA progress screen restore on failure
#include "../util/json.h"

#if !__has_include("../../secrets.h")
#error "Copy firmware/secrets.h.example to firmware/pomona/secrets.h and fill in the two passwords (docs/ota-and-secrets.md, Layer 1)"
#endif
#include "../../secrets.h"

#include <WiFi.h>
#include <WiFiUdp.h> // NTP for the photoperiod (#260)
#include <ArduinoMqttClient.h>
#include <PomonaVersion.h>
#include <mbed.h> // Watchdog kicks around blocking WiFi attempts

static WiFiClient wifiClient;
static MqttClient mqtt(wifiClient);

static uint32_t nextAttemptMs = 0;
static uint32_t backoffMs = NET_RETRY_MIN_MS;

static char otaUrlPending[224] = ""; // set by onMqttMessage, run in service
static bool i2cScanPending = false;  // set by onMqttMessage, run in service

// ---- clock (#260) ----------------------------------------------------
// Only the photoperiod (and the ts of our documents) uses this. The pump duty
// cycle is millis()-only, so a unit that never reaches an NTP server still
// waters correctly — it just holds the light off and says "no_time".
static WiFiUDP ntpUdp;
static uint32_t epochAtSync = 0;   // 0 = never synced
static uint32_t millisAtSync = 0;
static uint32_t nextNtpMs = 0;
static uint8_t ntpFailures = 0; // consecutive; odd = ask the fallback host next

uint32_t networkEpochNow() {
  if (epochAtSync == 0) return 0;
  return epochAtSync + (millis() - millisAtSync) / 1000UL;
}

// One NTP round trip, bounded by NTP_TIMEOUT_MS so the loop never stalls.
// True when the clock was set from the answer.
static bool ntpSync(const char *host) {
  uint8_t pkt[48] = {0};
  pkt[0] = 0b11100011; // LI = 3 (unsynchronised), version 4, mode 3 (client)
  if (!ntpUdp.begin(2390)) return false;
  bool ok = false;
  if (ntpUdp.beginPacket(host, 123)) {
    ntpUdp.write(pkt, sizeof(pkt));
    ntpUdp.endPacket();

    uint32_t t0 = millis();
    while (millis() - t0 < NTP_TIMEOUT_MS) {
      if (ntpUdp.parsePacket() >= 48) {
        ntpUdp.read(pkt, sizeof(pkt));
        // Transmit timestamp, seconds since 1900, bytes 40..43.
        uint32_t secs1900 = ((uint32_t)pkt[40] << 24) | ((uint32_t)pkt[41] << 16) |
                            ((uint32_t)pkt[42] << 8) | (uint32_t)pkt[43];
        const uint32_t SEVENTY_YEARS = 2208988800UL;
        if (secs1900 > SEVENTY_YEARS) {
          epochAtSync = secs1900 - SEVENTY_YEARS;
          millisAtSync = millis();
          ok = true;
          Serial.print("ntp: epoch ");
          Serial.print(epochAtSync);
          Serial.print(" from ");
          Serial.println(host);
        }
        break;
      }
      delay(10);
    }
  }
  ntpUdp.stop();
  return ok;
}

// The next NTP attempt: the full resync interval after a success, NTP_RETRY_MS
// after a failure (alternating hosts) — never 6 h of a dark tower for one lost
// packet at connect.
static void ntpService() {
  const char *host = (ntpFailures & 1) ? NTP_HOST_FALLBACK : NTP_HOST;
  if (ntpSync(host)) {
    ntpFailures = 0;
    nextNtpMs = millis() + NTP_RESYNC_MS;
  } else {
    if (ntpFailures < 255) ntpFailures++;
    nextNtpMs = millis() + NTP_RETRY_MS;
    Serial.print("ntp: no answer from ");
    Serial.print(host);
    Serial.println(", retry in 60 s");
  }
}

// ---- publishing helpers ----------------------------------------------

// A payload of known length, so nothing is silently cut at the client's
// default 256-byte buffer (sys/meta and the dose acks are longer).
static void pubSized(const char *topic, const char *body, bool retain, uint8_t qos) {
  mqtt.beginMessage(topic, (unsigned long)strlen(body), retain, qos);
  mqtt.print(body);
  mqtt.endMessage();
}

static void onMqttMessage(int /*messageSize*/) {
  String topic = mqtt.messageTopic();
  char payload[512]; // a `desired` document is the longest thing we read
  size_t n = 0;
  while (mqtt.available() && n < sizeof(payload) - 1)
    payload[n++] = (char)mqtt.read();
  payload[n] = '\0';
  while (mqtt.available()) mqtt.read(); // drain anything beyond the buffer
  if (topic == TOPIC_SYS_OTA_URL)
    snprintf(otaUrlPending, sizeof(otaUrlPending), "%s", payload);
  else if (topic == TOPIC_SYS_DIAG_I2C_GET)
    i2cScanPending = true; // any payload = scan now
  else if (topic == TOPIC_PUMP_SET)
    controlSetOverride(payload); // firmware keeps the safety veto (#260)
  else if (topic == TOPIC_LIGHT_SET)
    controlSetLightOverride(payload);
  else if (topic == TOPIC_DESIRED) {
    // Ceres's desired state: apply what this node supports (the stage);
    // targets, photoperiod and dosing_enabled are informational here.
    char stage[24];
    if (jsonGetString(payload, "stage", stage, sizeof(stage))) controlSetMode(stage);
  } else if (topic == TOPIC_DOSE_REQUEST)
    dosingHandleRequest(payload, networkEpochNow()); // the node's rails decide (#224)
}

bool wifiConnected() { return WiFi.status() == WL_CONNECTED; }
bool mqttConnected() { return mqtt.connected(); }

// ---- WiFi diagnostics (field bug: silent connect failures) -----------

static const char *wlStatusName(int s) {
  switch (s) {
    case WL_CONNECTED: return "CONNECTED";
    case WL_NO_SHIELD: return "NO_SHIELD/NO_MODULE";
    case WL_IDLE_STATUS: return "IDLE";
    case WL_NO_SSID_AVAIL: return "NO_SSID_AVAIL";
    case WL_SCAN_COMPLETED: return "SCAN_COMPLETED";
    case WL_CONNECT_FAILED: return "CONNECT_FAILED";
    case WL_CONNECTION_LOST: return "CONNECTION_LOST";
    case WL_DISCONNECTED: return "DISCONNECTED";
    default: return "?";
  }
}

// One-time module/firmware report at boot. On the GIGA the CYW4343W WiFi
// firmware lives in a QSPI partition; if that partition was never
// provisioned the core reports version "v0.0.0" ("" = no module at all)
// and every scan/connect fails — detect it and say exactly what to run.
static void wifiDiagnostics() {
  const char *fw = WiFi.firmwareVersion();
  int s = WiFi.status();
  Serial.print("WiFi: firmware ");
  Serial.print((fw && fw[0]) ? fw : "(none — no module?)");
  Serial.print(", status ");
  Serial.print(s);
  Serial.print(" (");
  Serial.print(wlStatusName(s));
  Serial.println(")");
  if (!fw || !fw[0] || strcmp(fw, "v0.0.0") == 0) {
    Serial.println("WiFi: !! WiFi firmware missing/unprovisioned — run the");
    Serial.println("WiFi: !! one-time STM32H747_System -> WiFiFirmwareUpdater");
    Serial.println("WiFi: !! sketch over USB, then reflash this firmware.");
  }
}

// After every attempt failed, scan once: distinguishes "radio dead / no
// firmware" (0 networks) from "our SSID not visible" from "visible but
// join refused" (passphrase/band).
static void wifiScanReport() {
  mbed::Watchdog::get_instance().kick(); // scan blocks a few seconds
  int8_t n = WiFi.scanNetworks();
  if (n <= 0) {
    Serial.println("WiFi: scan found NO networks — antenna on the UFL "
                   "connector? WiFi firmware provisioned?");
    return;
  }
  bool seen = false;
  for (int8_t i = 0; i < n; i++)
    if (strcmp(WiFi.SSID(i), WIFI_SSID) == 0) seen = true;
  Serial.print("WiFi: scan saw ");
  Serial.print(n);
  Serial.print(" network(s); SSID \"" WIFI_SSID "\" ");
  Serial.println(seen ? "IS visible — join refused (passphrase? band?)"
                      : "NOT visible (2.4 GHz off? hidden? out of range?)");
}

// ---- connect steps ---------------------------------------------------

static bool connectWifi() {
  for (int attempt = 1; attempt <= WIFI_BEGIN_ATTEMPTS; attempt++) {
    // each begin() blocks up to ~12 s (scan + 7 s connect timeout) —
    // kick the 30 s watchdog per attempt, never during one
    mbed::Watchdog::get_instance().kick();
    Serial.print("WiFi: connecting to \"" WIFI_SSID "\" (attempt ");
    Serial.print(attempt);
    Serial.print("/");
    Serial.print(WIFI_BEGIN_ATTEMPTS);
    Serial.println(")");
    int rc = WiFi.begin(WIFI_SSID, WIFI_PASS);
    if (rc == WL_CONNECTED) {
      Serial.print("WiFi: connected, IP ");
      Serial.print(WiFi.localIP());
      Serial.print(", RSSI ");
      Serial.print(WiFi.RSSI());
      Serial.println(" dBm");
      return true;
    }
    Serial.print("WiFi: attempt failed, status ");
    Serial.print(rc);
    Serial.print(" (");
    Serial.print(wlStatusName(rc));
    Serial.println(")");
  }
  wifiScanReport();
  return false;
}

// sys/meta — the node's self-description (ADR-0008): what it is, what it
// carries, how its dosers are calibrated and capped. Retained, on connect.
static void publishMeta() {
  char dosers[400];
  dosingMetaJson(dosers, sizeof(dosers));
  char buf[720];
  snprintf(buf, sizeof(buf),
           "{\"unit\":\"%s\",\"type\":\"%s\",\"node\":\"%s\",\"fw_version\":\"%s\",\"contract\":%d,"
           "\"sensors\":[\"water_temp\",\"ec\",\"ph\",\"level_points\",\"level_sonic\",\"bme280\",\"bh1750\"],"
           "\"actuators\":[\"pump\",\"light\"],\"reservoir_l\":%.1f,%s,\"ts\":%lu}",
           MQTT_UNIT_ID, UNIT_TYPE, UNIT_NODE, POMONA_FW_VERSION, MQTT_CONTRACT, (double)UNIT_RESERVOIR_L,
           dosers, (unsigned long)networkEpochNow());
  pubSized(TOPIC_SYS_META, buf, true, 1);
}

static bool connectMqtt() {
  mqtt.setId(MQTT_CLIENT_ID);
  mqtt.setUsernamePassword(MQTT_USER, MQTT_PASS);

  // last will: broker flips the retained status to offline if we vanish
  mqtt.beginWill(TOPIC_SYS_STATUS, true, 1);
  mqtt.print("offline");
  mqtt.endWill();

  Serial.print("[MQTT] connecting to ");
  Serial.print(MQTT_HOST);
  Serial.print(":");
  Serial.print(MQTT_PORT);
  Serial.print(" as ");
  Serial.println(MQTT_USER);
  if (!mqtt.connect(MQTT_HOST, MQTT_PORT)) {
    Serial.print("[MQTT] connect FAILED, error ");
    Serial.println(mqtt.connectError());
    return false;
  }

  mqtt.beginMessage(TOPIC_SYS_STATUS, true, 1);
  mqtt.print("online");
  mqtt.endMessage();
  publishMeta();

  mqtt.onMessage(onMqttMessage);
  mqtt.subscribe(TOPIC_SYS_OTA_URL, 1);      // basic OTA trigger (docs/mqtt.md)
  mqtt.subscribe(TOPIC_SYS_DIAG_I2C_GET, 1); // on-demand I2C scan trigger
  mqtt.subscribe(TOPIC_PUMP_SET, 1);         // auto|on|off (#260)
  mqtt.subscribe(TOPIC_LIGHT_SET, 1);        // auto|on|off (2.0.0)
  mqtt.subscribe(TOPIC_DESIRED, 1);          // the registry's desired state (stage)
  mqtt.subscribe(TOPIC_DOSE_REQUEST, 1);     // ml-based dose requests (#224)

  // Republish the actuator state on EVERY connect, not only on change: HA may
  // have been driving its own schedule while we were away, so the retained
  // state could predate the outage (docs/mqtt.md).
  controlForcePublish();

  nextNtpMs = 0; // resync the clock now that we have a network

  Serial.println("[MQTT] connected");
  return true;
}

// Run a queued OTA request outside the MQTT receive callback. On success
// the unit reboots inside otaApplyFromUrl and never returns here.
static void handleOtaPending() {
  if (otaUrlPending[0] == '\0') return;
  char url[sizeof(otaUrlPending)];
  snprintf(url, sizeof(url), "%s", otaUrlPending);
  otaUrlPending[0] = '\0';

  // Same-version guard: the broker replays queued QoS1 ota_url messages on
  // every reconnect (seen on the bench 2026-08-28 — a stale trigger kept
  // re-installing the running version in a loop). A URL naming the version
  // we already run is a replay, not an update: skip it.
  if (strstr(url, "pomona-" POMONA_FW_VERSION ".ota") != NULL) {
    Serial.print("ota: skipping same-version replay ");
    Serial.println(url);
    mqtt.beginMessage(TOPIC_SYS_OTA_RESULT, true, 1);
    mqtt.print("skipped same-version ");
    mqtt.print(url);
    mqtt.endMessage();
    return;
  }

  mqtt.beginMessage(TOPIC_SYS_OTA_RESULT, true, 1);
  mqtt.print("applying ");
  mqtt.print(url);
  mqtt.endMessage();

  char err[96];
  if (!otaApplyFromUrl(url, err, sizeof(err))) {
    Serial.print("ota: FAILED — ");
    Serial.println(err);
    if (mqtt.connected()) {
      mqtt.beginMessage(TOPIC_SYS_OTA_RESULT, true, 1);
      mqtt.print("failed: ");
      mqtt.print(err);
      mqtt.endMessage();
    }
    char stage[128];
    snprintf(stage, sizeof(stage), "update failed: %s", err);
    displayOtaScreen(stage); // leave the reason visible a moment...
    delay(4000);
    displayRestoreMain(); // ...then back to the readings
  }
}

// ---- public API ------------------------------------------------------

void networkInit() {
  // Boot-time diagnostics only; networkService() connects lazily, so the
  // screen comes up immediately even with WiFi down.
  wifiDiagnostics();
}

// Rescan the I2C bus and publish the retained diagnostics topic. Runs on
// every publish cycle and immediately on a message to TOPIC_SYS_DIAG_I2C_GET.
static void publishI2CScan() {
  char addrs[96];
  char buf[128];
  int found = sensorsI2CScan(addrs, sizeof(addrs));
  snprintf(buf, sizeof(buf), "{\"found\":%d,\"addrs\":\"%s\"}", found, addrs);
  mqtt.beginMessage(TOPIC_SYS_DIAG_I2C, true, 1);
  mqtt.print(buf);
  mqtt.endMessage();
}

void networkService() {
  if (wifiConnected() && mqtt.connected()) {
    mqtt.poll(); // keepalive + inbound (ota url, diag get, set, desired, dose request)
    handleOtaPending();
    if (i2cScanPending) {
      i2cScanPending = false;
      publishI2CScan();
    }
    const char *doseEv = dosingTakeEvent();
    if (doseEv) pubSized(TOPIC_DOSE_RESULT, doseEv, true, 1); // retained: last action / ack
    if ((int32_t)(millis() - nextNtpMs) >= 0) ntpService();
    // Actuator decisions are published on change, not on the 30 s metric
    // cadence: a stop is worth telling HA about immediately.
    if (controlWantsPublish()) networkPublishControl();
    return;
  }

  if ((int32_t)(millis() - nextAttemptMs) < 0) return; // backoff window

  bool ok = wifiConnected() || connectWifi();
  if (ok) ok = connectMqtt();

  if (ok) {
    backoffMs = NET_RETRY_MIN_MS;
  } else {
    nextAttemptMs = millis() + backoffMs;
    Serial.print("net: retry in ");
    Serial.print(backoffMs / 1000);
    Serial.println(" s");
    backoffMs = min(backoffMs * 2, NET_RETRY_MAX_MS);
  }
}

// ---- publishing ------------------------------------------------------

static void pubFloat(const char *topic, float v, uint8_t decimals) {
  mqtt.beginMessage(topic);
  mqtt.print(v, decimals);
  mqtt.endMessage();
}

static void pubInt(const char *topic, long v) {
  mqtt.beginMessage(topic);
  mqtt.print(v);
  mqtt.endMessage();
}

// Retained + QoS 1, unlike the metrics: this is the current DESIRED state, so
// a broker replay on HA restart is exactly what we want (docs/mqtt.md).
static void pubRetained(const char *topic, const char *value) {
  mqtt.beginMessage(topic, true, 1);
  mqtt.print(value);
  mqtt.endMessage();
}

void networkPublishControl() {
  if (!mqtt.connected()) return;
  pubRetained(TOPIC_PUMP_STATE, controlPumpOn() ? "on" : "off");
  pubRetained(TOPIC_PUMP_REASON, controlReasonStr());
  pubRetained(TOPIC_LIGHT_STATE, controlLightOn() ? "on" : "off");
  controlMarkPublished();
  Serial.print("[MQTT] actuators pump=");
  Serial.print(controlPumpOn() ? "on" : "off");
  Serial.print(" light=");
  Serial.print(controlLightOn() ? "on" : "off");
  Serial.print(" reason=");
  Serial.println(controlReasonStr());
}

void networkPublish(const Readings &r) {
  if (!mqtt.connected()) return;

  // water — only what the sensors actually answered (docs/mqtt.md)
  if (r.waterTempOk) pubFloat(TOPIC_WATER_TEMP, r.waterTempC, 1);
  pubFloat(TOPIC_WATER_EC, r.ecMsCm, 2); // analog: always published — between pump runs since 2.4.4
  pubFloat(TOPIC_WATER_EC_LIVE, r.ecLiveMsCm, 2); // this sweep's reading, pump on or off
  if (r.phOk) pubFloat(TOPIC_WATER_PH, r.ph, 2);
  if (!isnan(r.phRawV)) pubFloat(TOPIC_WATER_PH_RAW, r.phRawV, 3); // calibration/drift aid
  // level_pct: the calibrated ultrasonic owns it (#283); the Grove strip only
  // when no calibrated ultrasonic is there — never both on one topic.
  if (r.tankOk) {
    pubFloat(TOPIC_WATER_LEVEL_PCT, r.tankPct, 1);
    pubFloat(TOPIC_WATER_VOLUME, r.tankL, 2);
  } else if (r.levelOk) {
    pubInt(TOPIC_WATER_LEVEL_PCT, r.levelPct);
  }
  if (r.tankDistOk) pubInt(TOPIC_WATER_LEVEL_DIST, r.tankDistMm); // every sweep, pump on or off (2.4.8)
  if (r.tankDistLiveMm >= 0) pubInt(TOPIC_WATER_LEVEL_DIST_LIVE, r.tankDistLiveMm); // the same value since 2.4.8
  if (r.probePoints >= 0) pubInt(TOPIC_WATER_LEVEL_POINTS, r.probePoints);

  // air
  if (r.bmeOk) {
    pubFloat(TOPIC_AIR_TEMP, r.airTempC, 1);
    pubFloat(TOPIC_AIR_RH, r.humidityPct, 1);
    pubFloat(TOPIC_AIR_PRESSURE, r.pressureHpa, 1);
  }
  if (r.luxOk) pubFloat(TOPIC_AIR_LUX, r.lux, 0);

  // node health as telemetry
  pubInt(TOPIC_NODE_RSSI, WiFi.RSSI());
  pubInt(TOPIC_NODE_UPTIME, millis() / 1000);

  // sys/health — retained availability map: consumers see which metrics to expect
  // level_sonic_frames: the A02YYUW's counters since boot — a silent sensor's cause at a glance
  // (bad climbing: garbage / no echo, e.g. tilted; near: water at the face; none: wiring/power).
  char buf[400];
  snprintf(buf, sizeof(buf),
           "{\"water_temp\":%s,\"ph_calibrated\":%s,\"level_strip\":%s,"
           "\"level_probe\":%s,\"level_sonic\":%s,\"level_sonic_calibrated\":%s,"
           "\"level_sonic_frames\":{\"good\":%lu,\"near\":%lu,\"bad\":%lu},"
           "\"level_sonic_state\":\"%s\",\"level_held\":%s,\"ec_held\":%s,"
           "\"bme280\":%s,\"bh1750\":%s,\"ts\":%lu}",
           r.waterTempOk ? "true" : "false", r.phOk ? "true" : "false",
           r.levelOk ? "true" : "false", r.probePoints >= 0 ? "true" : "false",
           r.tankDistOk ? "true" : "false", r.tankCalibrated ? "true" : "false",
           (unsigned long)r.sonicGood, (unsigned long)r.sonicNear, (unsigned long)r.sonicBad,
           r.tankState, r.tankHeld ? "true" : "false", r.ecHeld ? "true" : "false",
           r.bmeOk ? "true" : "false", r.luxOk ? "true" : "false",
           (unsigned long)networkEpochNow());
  pubSized(TOPIC_SYS_HEALTH, buf, true, 1);

  // retained I2C diagnostics: what actually answers on the bus right now,
  // so a headless unit's wiring can be checked over MQTT (docs/mqtt.md)
  publishI2CScan();
}
