jellebens/pomona/(commit log)

2026-07-29 docs(seeding): add seeding/ with alpine strawberry from seed; docs TOC
    Owner has seed, not plugs: Erdbeere Rote Baron Solemacher = Fragaria vesca
    var. semperflorens (alpine/Monatserdbeere). Key correction — it is a
    Lichtkeimer, so seed is surface-sown UNCOVERED; the generic sow-into-the-hole
    method would have failed. Runnerless, compact, fruits in year one.
    - docs/seeding/strawberry.md: variety traits, surface sowing on sponges,
    ~20 positions for 10 plants, optional cold-strat hedge, transplant gate
    (3-4 true leaves, ~6-8 wks), crown-above-medium, EC ~1.2 while
    strawberry-only.
    - docs/seeding/README.md: shared sponge method (moved out of planting-plan),
    sowing order slowest-first,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
2026-07-29 docs(seeding): sponges confirmed for all crops; cross-cut sowing technique
    Medium decided: grow sponges everywhere, rockwool dropped (alkaline, needs a
    pH 5.5 pre-soak, crusty top and algae on a wet lit surface - all bad for a
    surface-sown light germinator).
    Sponges are cross-cut into four wedges, gaping when dry. Seed dropped into
    the slit is lost in the dark, so: soak first (slits swell shut), then sow on
    the wedge top faces beside the junction, or pinch-place-release so the wedges
    cradle the seed at the surface. Adds the pipette water-drop method for
    dust-fine seed. Refs Trello #219.
2026-07-29 docs(seeding): sponge is a small central hole with four radial cuts
    Corrects the sponge description to what the owner actually has: a little
    central bore with four cuts radiating from it, so the top is four quadrant
    faces. Sow on a quadrant face ~5mm out from the hole, seeds spread across
    quadrants; the hole and cuts are for the stem and roots at transplant, not
    for sowing. Drops a duplicated pipette paragraph. Refs Trello #219.
2026-07-29 docs(seeding): strawberry sowing quantity - 12 sponges now, batch 2 conditional
    The ~20-position figure overshot: only 10 pods are reserved for strawberry
    and ~5 seeds per sponge means nearly every sponge yields a plant, so 20
    sponges grows ~19 candidates for 10 slots.
    Batch 1 = 12 sponges (10 pods + 2 transplant losses). Remaining seed goes to
    the fridge to cold-stratify, and batch 2 becomes conditional on a 3-week
    count of batch 1: >=8 skip, 4-7 top up with ~6, <4 diagnose before re-sowing.
    Notes that a later wave transplants deeper into the dark season and likely
    waits until spring to fruit. Refs Trello #219.
2026-07-29 docs(seeding): gate full sowing behind a 5-sponge PoC
    Owner decision: prove the seedling technique and the sensor/MQTT/Grafana
    stack on 5 sponges before committing the packet and all 30 pods. Nothing is
    instrumented yet (#218/#220), nothing is dosed, there is no grow light, and
    the hardest crop is an untried surface-sown light germinator.
    PoC = 3 strawberry (hard case, also the slowest crop) + 2 lettuce (fast
    validator, up in 2-7 d, yields an actual harvest ~5-6 wks in). Tray at
    20-22 C, the strawberry/lettuce overlap window. Remaining seed goes to the
    fridge to cold-stratify.
    Adds exit criteria in three groups (seedling technique, hardware/software
    per #218/#220/#222, transplanting), and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
2026-07-29 docs: drop the vine tomato; rebalance pods and lower the shared EC
    Owner decision (2026-07-29): the tros (vine) tomato added earlier the same
    day is out. With the cherry tomato already replaced, there is now no tomato
    in the tower at all.
    Why it went: indeterminate at 1.5-2 m with heavy trusses, it would have
    shaded the tiers above and dominated reservoir draw in a 25x25x86 cm tower on
    10 L, and it demanded EC 2.0-3.0 against lettuce 0.8-1.2 on one shared
    reservoir.
    - Its 2 pods go to basil (4->5) and parsley (2->3), the highest-turnover
    cut-and-come-again herbs. Chili and dill stay at 1 deliberately.
    - Shared EC lowered 1.6-1.8 -> 1.4-1.6: the truss tomato was the only crop
    pulling th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
2026-07-29 docs(seeding): consistency sweep + do-not-germinate-in-the-dark warning
    Reconciles the seeding docs with the decisions taken after they were written.
    - strawberry.md: splits sowing quantity into PoC (3 sponges NOW) vs the main
    sowing (12 sponges, after the PoC passes) - the doc previously told the
    reader to sow 12 today, contradicting poc.md. Renames batch 1/2 to main
    sowing/top-up wave to stop the collision with the tower-wide batch names.
    - Adds an explicit warning against the warm-dark-cupboard habit: a
    Lichtkeimer needs light on the seed from day one, so dome + bright INDIRECT
    light, never a dark place. Owner nearly did this.
    - Records tray water precisely: 2-3 mm plain demin,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
2026-08-03 docs(seeding): per-crop sowing table; all seed bought; two-tray temperature split
    All seed is now on hand, so nothing is blocked on a purchase and the rest of
    the plan can be sown.
    - Adds a per-crop sowing table: sponge counts (overplanted, with the pod
    target), seeds per sponge, sowing depth, tray temperature, germination days.
    - NEW and easy to get wrong: the crops do not share one tray. Peppers want
    25-28 C while lettuce fails above ~24 C and strawberry sits at 20-24 C, so
    a warm tray (peppers, buried seed, no light needed until sprouted) and a
    cool bright tray (strawberry, lettuce, parsley, later basil and dill) are
    required.
    - Sowing order now that everything is on hand: pepp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
2026-08-03 docs(seeding): hot-weather guidance - ambient 28 C helps peppers, breaks the rest
    Ambient recorded at 28 C on the sowing day. That is not neutral:
    - Peppers/chili need no heat mat at all - 28 C is their band. Sow now.
    - But there is no COOL tray at 28 C ambient, and three crops need one.
    Lettuce hits thermodormancy above ~27 C (it actively refuses to germinate,
    so sowing now largely wastes seed); dill wants 15-21 C; parsley 18-24 C and
    is already the most erratic germinator here. Basil is fine - heat-tolerant.
    - Most urgent: the 12 strawberry sponges already sown are in the wrong band.
    Above ~25 C germination falls off, and a domed tray with sun on it in a
    28 C room can exceed 35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
2026-08-07 docs+firmware: sensor unit wiring plan + serial bring-up sketch (#220)
    Wiring guide (GIGA pin map, I2C address plan incl. BME280 0x76 strap, pH isolation chain, placement, first-power-on checklist, EC/pH calibration procedure) and a bench bring-up sketch that scans the bus and prints all v1 sensor readings over serial. No MQTT/display yet.
2026-08-25 firmware+docs: level strip calibration — raw pad dump sketch + mount/threshold procedure (#242)
2026-08-25 firmware: extract Grove level strip driver into shared GroveWaterLevel library (#242)
    Both bringup and leveltest now use firmware/libraries/GroveWaterLevel (raw pads, wet threshold, wet count/percent/depth) instead of duplicated Wire code; #229's firmware v1 reuses it too. Compile-verified for arduino:mbed_giga:giga. README documents the sketchbook/--libraries setup.
2026-08-25 firmware+docs: CQRSENYW003 photoelectric level probe — driver, test sketch, role split with Grove strip (#242)
    Owner has a CQRobot contact multi-point photoelectric probe: 4 optical points over ~3 cm, frequency output (20 Hz dry, 50/100/200/400 Hz pts 1-4), immersion-safe. New PhotoLevelProbe library (pulseIn period -> points 0-4, geometric-midpoint bands) + levelprobe test sketch + bringup integration on D3. Docs: probe becomes the in-tank low-water ladder at pump-intake height; Grove strip demoted to optional through-wall coarse gauge outside the tank. Compile-verified for arduino:mbed_giga:giga.
2026-08-25 docs: record level probe calibration — dip test pass, point 1 = 8.2 L top-up mount (#242)
    All 4 points verified on the bench (~50/100/200/400 Hz, dry 20.2 Hz). As built the probe is a top-up gauge: point 1 wets at 8.2 L, 0/4 = below 8.2 L = refill alert; documented that there is no dry-run coverage below that line. Live in-tank reading 50.5 Hz = 1/4 consistent.
2026-08-25 docs: level probe point 3 observed at 9.7 L; interpolate 2, extrapolate 4 (#242)
2026-08-25 docs: level-probe reading ladder + current-state refresh (#242)
    wiring.md gains the points->action ladder for #222 (3+=full, 2=ok, 1=top up soon, 0=refill now / blind below 8.2 L); docs/README.md current state updated: first sensor live, bring-up in progress, remaining sensors listed.
2026-08-25 docs: add assumptions.md — level-probe calibration assumptions A1-A4 (#242)
    Records the working assumptions behind the level-probe numbers: A1 linear ~0.75 L/point spacing (basis for the interpolated pt 2 / extrapolated pt 4), A2 point 4 never triggers in normal use, A3 top-up mount without dry-run protection accepted by owner, A4 mechanical indicator as unverified volume reference. Each with basis, impact-if-wrong and verification path; linked from docs TOC and wiring.md.
2026-08-25 docs: restructure to one doc per sensor under docs/sensors/ (#242)
    Owner request: per-sensor docs instead of monolithic wiring.md + assumptions.md. New docs/sensors/{README,level-probe,level-strip,water-temp,ec-tds,ph,air-bme280,light-bh1750,pump-power}.md — each holds its sensor's wiring, verification, calibration (procedure + recorded values) and assumptions. assumptions.md A1-A4 folded into level-probe.md; CQRobot product link added. wiring.md slimmed to shared ground rules + combined pin map (with doc links) + first-power-on checklist. TOC and firmware README links updated.
2026-08-25 docs: DS18B20 wired via old pH module T2 + ice-bath verified, no offset (#242)
    As-built wiring documented (module as breakout: Vcc at 3V3 ONLY, T2->D2, onboard pull-up; P0/T1 unused). Ice-bath calibration: stable minimum 0.3-0.4 C at a 0.0 C pen reference = within the +/-0.5 C factory spec, no offset applied. Bath-technique note added (earlier 5-6 C plateaus were bath artifacts). bringup.ino comment pointer updated to docs/sensors/.
2026-08-25 docs: full pinout + reference for the Logo-Rnaenaor pH module used as DS18B20 breakout (#242)
    Pinout as posted by the owner (Vcc/GND/GND/P0/T1/T2) with per-pin function and our use; link to the bestengineeringprojects.com article identifying the board; captured the relevant module details (BNC, offset + pH-limit pots, 2.5V-at-pH7 calibration midpoint) with a warning that the article's 5V calibration procedure conflicts with our 3V3-only rule while T2 is on the GIGA.
2026-08-25 docs: add official GIGA R1 WiFi pinout (PNG + full PDF) and board reference links (#242)
    Pinout diagram embedded in wiring.md (rendered from page 1 of Arduino's ABX00063 full-pinout PDF, which is committed alongside for the remaining pages incl. high-density connectors). Links: product page (store.arduino.cc), docs page, datasheet. Captured notes: A8-A11 analog-only, 140 mA total / 20 mA per-pin I/O limits, WiFi requires the UFL antenna (relevant to #229 MQTT and #243 OTA).
2026-08-26 docs: OTA + secure-secrets design (ATECC608A, layered) and Layer-1 secrets plumbing (#243/#244)
    docs/ota-and-secrets.md: threat model, layered secret storage (gitignored arduino_secrets.h now -> ATECC608A data slots via provisioning sketch -> optional TLS client auth with in-chip ECC key), OTA in two flavors (IDE/arduino-cli network-port push for the bench; Arduino_Portenta_OTA pull from a cluster-served .ota for production) with bootloader+QSPIFormat prereqs and the prove-on-bench-before-mounting rule. Plumbing: firmware/arduino_secrets.h.example template, arduino_secrets.h gitignored, firmware README secrets section, docs TOC row.
2026-08-26 firmware: semver version banner + auto-bumping deploy script, v0.1.0 (#243)
    libraries/PomonaVersion holds POMONA_FW_VERSION (single source of truth, starts 0.1.0); all three sketches print it in their boot banner. firmware/deploy.ps1 bumps the version semver-style on every deploy (patch default, -Bump minor/major/none), builds with the bundled Windows arduino-cli straight from the repo path, and flashes over USB; the OTA flow will reuse the same version for its update check. Verified on hardware: deployed via the script, boot banner prints 'Pomona bring-up v0.1.0'.
2026-08-26 #229 Pomona: GIGA firmware v1 — MQTT publish + LVGL current-readings screen (#28)
    * feat(firmware): pomona v1 app sketch — MQTT publish, LVGL screen, blanking, basic OTA (#229)
    New from-scratch application sketch firmware/pomona/pomona.ino (modular:
    config / sensors / network / display / ota):
    - WiFi + MQTT (ArduinoMqttClient) to the cluster EMQX, exponential-backoff
    reconnect, LWT online/offline, publishes per docs/mqtt.md; absent sensors
    publish nothing and are flagged in the retained unit/sensors map
    - LVGL 9 current-readings screen (Arduino_H7_Video + GigaDisplayTouch),
    one tile per metric, fw version bottom-right, -- for unavailable values
    - screen blanking (#248): backlight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
2026-08-26 refactor(firmware): move pomona modules into src/<module> folders; slim secrets.h to passwords only (#251) (#29)
    - git mv display/network/sensors/ota .h/.cpp into firmware/pomona/src/
    <module>/ (Arduino compiles sketch root + src/**); pomona.ino, config.h
    and the gitignored secrets.h stay at the sketch root; include paths
    updated accordingly — no behavior change
    - config/secrets split rework (owner): non-secret connection settings now
    committed in config.h (WIFI_SSID "B3ns-2-4", MQTT_HOST mqtt.lab.local,
    MQTT_PORT 1883, MQTT_USER pomona); secrets.h holds ONLY WIFI_PASS +
    MQTT_PASS; SECRET_ prefix dropped everywhere; secrets.h.example now
    just the two passwords
    - READMEs (sket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
    [config.h, display.cpp, display.h, network.cpp, network.h, ota.cpp, ota.h, pomona.ino]
2026-08-26 docs(changelog): add CHANGELOG.md — v0.1.4 release notes generated from master history (#33)
2026-08-27 fix(firmware): verify OTA download size on flash and retry — core download() returns Content-Length, not bytes written (#243) (#35)
    Bench-diagnosed: decompress failed (-5) was a truncated /fs/UPDATE.BIN.LZSS; a corrupted OTA-partition FAT deterministically stopped writes at 4096 B while download() reported full size. Adds stat-based size verify + delete-and-retry (OTA_DOWNLOAD_ATTEMPTS), README runbook notes, version bumps 0.1.4->0.1.9 from the bench deploy/OTA session.
    [config.h, ota.cpp]
2026-08-27 fix(firmware): feed the watchdog during OTA decompress/download (#243) (#36)
    The Arduino_Portenta_OTA library only feeds the IWDG if setFeedWatchdogFunc callbacks are registered — without them the 1-2 min decompress starved the 30 s watchdog, resetting the device mid-apply (the root cause of every silent OTA reboot-into-old-version, and via mid-write resets also of the corrupted OTA-partition FAT). Registers the kick for both the OTA stages and the WiFi download path. Bench-proven: full OTA chain delivered v0.1.11 over the air (download 581678 B verified, decompressed 728552 B, staged, bootloader applied).
    [ota.cpp]
2026-08-28 feat(firmware): remote I2C diagnostics, boot screen, BME280 alt addr, OTA replay guard, tap-title info screen (v0.1.13-v0.1.18)
    Bench session 2026-08-28, delivered incrementally over the air:
    - v0.1.13: retained pomona/unit/i2c_scan published each cycle (headless wiring checks)
    - v0.1.14: on-demand scan via pomona/unit/i2c_scan/get subscription
    - v0.1.15: boot banner (superseded by v0.1.17) + BME280 accepted at 0x76 or 0x77 (unstrapped board; Grove level strip retired)
    - v0.1.16: same-version OTA replay guard — broker QoS1 redeliveries kept re-installing the running version in a loop
    - v0.1.17: real boot screen (Pomona / version / I2C scan, min-hold, then tiles) replacing the overlay banne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
    [config.h, display.cpp, display.h, network.cpp, pomona.ino, sensors.cpp, sensors.h]
2026-08-28 feat(firmware): OTA progress screen — stages + countdown + do-not-power-off (v0.1.19)
    Owner request: the OTA blocks the loop for 3-5 min with a frozen screen. Now a full-screen Updating firmware view shows each stage (downloading try n/m, decompressing, installing, rebooting), a live elapsed/remaining countdown driven from the watchdog-feed callback, and a do-not-power-off warning (a power cycle mid-apply is the one dangerous window). Failures show the reason for 4 s, then restore the tiles with cached readings. v0.1.19.
    [config.h, display.cpp, display.h, network.cpp, ota.cpp]
2026-08-28 chore(firmware): bump version to 0.1.20 (USB recovery flash after interrupted OTA)
2026-08-28 fix(display): info screen inherits tiles flex layout — misaligned title, tap-catcher off-screen (v0.1.21)
    [display.cpp]
2026-08-28 feat(display): finer boot progression — sensors, I2C, WiFi, MQTT line by line (v0.1.22)
2026-08-28 fix(sensors): wedged I2C bus can no longer boot-loop the unit (v0.1.23)
    A miswired run holding SDA/SCL low made every I2C op wait out its timeout; the 127-address scan outlived the 30 s IWDG and the unit boot-looped (bench 2026-08-28). Now: raw pin check before first I2C use — stuck bus skips I2C entirely and reports SDA/SCL stuck LOW on the boot screen and pomona/unit/i2c_scan; watchdog fed inside both scan loops; Grove level read guarded. Fixing the wiring needs a power cycle to re-enable I2C.
    [sensors.cpp]
2026-08-28 fix(display): OTA screen also inherits tiles flex layout — clipped title (v0.1.24)
    [display.cpp]
2026-08-28 fix(sensors): drop bme/lux availability flags when reads go invalid — honest flags on a flaky cable (v0.1.25)
    [sensors.cpp]
2026-08-28 feat(calibration): EC calibrated — EC_CAL_K 0.9745 from 1413 uS/cm fluid at 25.6 C (v0.1.26)
2026-08-28 docs(sensors): 20 ml calibration fluid proved sufficient
2026-08-28 feat(sensors): publish raw pH voltage + configurable buffer anchors 7.00/4.00 (v0.1.27)
2026-08-28 feat(calibration): pH two-point calibrated — 1.39V @ 7.00, 2.09V @ 4.00 (v0.1.28)
2026-08-28 fix(calibration): pH re-calibrated after wet-up drift — 1.56V @ 7.00, 2.10V @ 4.00, validated at 10.01 (v0.1.29)
2026-08-28 feat(display): water level tile as OK/WRN/CRIT status word — >=3 pts green, 1-2 amber, 0 red (v0.1.30)
2026-08-28 chore(release): version 1.0.0 — all v1 sensors connected and calibrated on the assembled unit
2026-08-31 docs(seeding): correct the lettuce death date, open the transplant window, add a transplant runbook
    Owner confirmed today is 2026-08-31, not the 08-07 the WSL clock reported.
    Sow (08-03) and germination (08-07) dates were right; the DEATH date was not.
    - Lettuce death re-dated: reported 2026-08-31, exact date unrecorded. That gap
    is itself the first lesson - nothing was watching the tray.
    - Diagnosis refined: the strawberries survived the same four weeks in the same
    tray, so a cause that kills everything (cooked, total dry-out) is unlikely.
    Damping-off or lettuce-specific heat stress fits the evidence better.
    - The forward schedule is no longer forward: the strawberry transplant windo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
2026-08-31 docs(seeding): how the sponge seats in the net pod
    Answers two questions that came up mid-transplant.
    - The seedling NEVER leaves the sponge - no pulling out, no rinsing, no
    teasing roots apart. The sponge is part of the plant from here on.
    - Seat, do not squeeze. A firm press to settle it is fine; compressing or
    jamming it collapses the sponge structure, drives the air out and leaves it
    permanently waterlogged - the same mistake as wringing one out by hand.
    Loose in the cup: pack clay pebbles around the outside rather than stuffing
    more sponge in. Too big: pare a sliver off the outside edge, clear of roots.
    - Roots already out of the sponge go DOWN through the net slots to hang f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
2026-08-31 docs(level-probe): mount is permanent, and a raw 0 mid-cycle is not trustworthy
    Two things changed since this doc was written: the tower was planted and the
    pump now runs on an unattended HA schedule (so a dry-run can happen at 03:00
    with nobody watching), and the owner established that the probe CANNOT be
    remounted at pump-intake height - the tank geometry does not allow it.
    - A3 keeps its status but its ESCAPE HATCH IS CLOSED. Top-up mount without
    dry-run protection is no longer a choice among options; it is the permanent
    shape of this instrument. Notes what real dry-run protection would now cost:
    added hardware, not a different mounting height - a second probe low on
    another pin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
2026-08-31 docs(control): design note on where the pump and light logic should live
    Owner asked whether the pump and light logic could move into the Arduino
    behind relays, with the argument that the Arduino would then contain ALL the
    logic. It is the strong argument, and this note takes it seriously.
    Today the logic is smeared across three systems: sensing in firmware,
    scheduling and the level interlock in two HA packages, actuation in smart
    plugs. That split is the direct cause of the awkwardness in the settle check -
    the device holding the level reading cannot stop the pump, so a low-water
    response has to travel GIGA -> MQTT -> broker -> HA -> Z-Wave -> plug. It also
    means an HA outage stops irrigat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
2026-08-31 docs(mqtt): control topics - the GIGA decides, HA relays to the plugs
    Records the contract the HA side was just built against (home-assitant PR #16,
    merged): pomona/pump/request, pomona/light/request and pomona/pump/reason.
    Firmware side is not written yet; this is the agreed interface so both halves
    match.
    pomona/pump/request on|off RETAINED QoS 1
    pomona/light/request on|off RETAINED QoS 1
    pomona/pump/reason schedule|level_low|settling|override|boot_safe
    Retained, unlike the metrics, and the reasoning is written down: metric topics
    are deliberately non-retained because a stale reading is worse than none, while
    a REQUEST is the current desired state and having the brok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
2026-08-31 feat(firmware): local pump + light control, published as requests (#260)
    The firmware half of event -> HA -> Fibaro. The HA side is already merged
    (home-assitant PR #16) and the topic contract is in docs/mqtt.md; this makes
    the unit the thing that decides.
    NOT COMPILE-VERIFIED. There is no arduino-cli in WSL, so this has been written
    and reviewed by inspection only. It must be built before it is flashed, and
    flashing stays owner-gated.
    New src/control module:
    - Duty cycle 15 min on, off 15 min (establishment) / 45 min (established day) /
    105 min (established night). Runs on millis() ALONE, so a unit with no
    network still waters correctly. Publishing is reporting, not deciding.
    - Photop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
    [config.h, network.cpp, network.h, pomona.ino]
2026-08-31 docs(firmware): record the clean build for the control module
    Compiled from WSL with the arduino-cli already in ~/.local/bin (it was simply
    not on PATH in a non-login shell, which is why the first attempt reported no
    toolchain).
    arduino-cli compile --clean --warnings all --fqbn arduino:mbed_giga:giga --libraries libraries pomona
    Clean: no errors, and no warnings from src/control or src/network. The only
    warning is the pre-existing BH1750 architecture notice, unrelated to this
    change. 728,292 B flash (37%), 137,856 B RAM (26%).
    Still not flashed - deploys stay owner-gated.
    Refs Trello #260.
2026-08-31 chore(version): 1.1.0 — minor bump for the #260 control feature; changelog
    Features bump minor (owner rule 2026-08-31). Not yet built or flashed;
    the unit stays on 1.0.0 until the next owner-gated OTA.
2026-09-01 feat(display): water level tile follows the 2026-09-01 level semantics
    2 pts = OK (target fill), 1 = LOW / 3-4 = HIGH amber, 0 = CRIT — matches
    the Grafana Reservoir tile. Ships with the next OTA (no bump here; the
    release flow bumps).
2026-09-02 feat(display): band color coding on all metric tiles
    pH/EC/water-temp/air-temp/RH values render green in the target band,
    amber in tolerance, red beyond (BAND_* constants in config.h — match
    Tethys + the Grafana dashboard; EC = transplant band, ramp at #262).
    Pressure and lux stay neutral. Compile-verified.
    [config.h, display.cpp]
2026-09-03 feat(dosing): bench-test module for the DFR0523 channels (#284)
    pomona/dose/test drives ch1-4 (D4-D7) via servo PPM: chN fwd|rev|stop
    [ms] [speed 1-100], hard-capped at 10 s per command, one channel at a
    time, all channels held at explicit stop from boot. Retained
    pomona/dose/result reports each action. Bring-up/calibration only — no
    autonomous dosing (that is the #224 controller, later). Adds the Servo
    library dependency (arduino-cli lib install Servo).
2026-09-03 fix(dosing): generate PPM with mbed PwmOut — Servo lib holds the pin high on GIGA
    Measured ~3V average on D4 where a servo frame averages 0.1-0.4V; explicit
    20 ms period + pulsewidth_us instead. Drops the Servo dependency.
    [dosing.cpp]
2026-09-04 feat(dosing): serial debug commands for the bench session
    dose chN fwd|rev|stop [ms] [speed], dose status (per-channel pin + pulse
    + run state), help — same code path as pomona/dose/test; every dose
    event also mirrors to Serial.
2026-09-04 fix(dosing): use DFRobot GravityPump reference pulse values
    544us max fwd / 1472us stop / 2400us max rev @50Hz — bit-for-bit what
    DFRobot own library emits (Servo.attach(pin) defaults + write(0..180)).
    Replaces the datasheet-edge 500/1500/2500 mapping.
    [dosing.cpp]
2026-09-04 feat(display,dosing): OTA screen force-awake + tagged serial logs
    - OTA progress now forces the panel visibly on (backlight + blank-shield
    removal + idle reset every stage/tick) — before, a blanked screen showed
    a lit black rectangle through the whole update and could re-blank
    mid-apply.
    - Serial log tags: dosing events print as [PUMP001]..[PUMP004], MQTT
    lifecycle prints as [MQTT].
    [display.cpp, dosing.cpp, network.cpp, pomona.ino]
2026-09-04 docs(dosing): DFR0523 as-built — ch1 commissioned + calibrated (#284)
    Channel table (ch1: D4, 0.73 ml/s full / 0.26 slow / 0.30 @75 — nonlinear
    curve, calibrate never interpolate; green in, blue out on fwd), wiring
    incl. LRS-50-5 + common-GND lesson, the polarity casualty, the Servo-lib-
    on-GIGA warning with DFRobot reference pulses, commands, calibration
    procedure.
2026-09-05 docs(dosing): ch2 + ch3 commissioned and calibrated (#285, #286)
    ch2 (Nutrient A, D5): 0.50 ml/s full (5.0x3, zero spread) / 0.24 @50.
    ch3 (Nutrient B, D6): 0.60 ml/s full (18 ml over 3x10s, post break-in).
    Break-in drift lesson: fresh tubes climb ~10% before settling — pre-run
    new tubes, recalibrate all channels after the first week.
2026-09-05 docs(dosing): ch3 slow-speed constant 0.20 ml/s (#286)
2026-09-09 chore(dosing): final wiring pin map — ch1 D13, ch2 D10, ch3 D11, ch4 D12
    Owner layout 2026-09-09 (perm wiring); bench block D4-D7 retired. Doc
    channel table updated with old pins noted.
2026-09-09 fix(dosing): ch1 pH-Down = D12, spare = D13 (owner correction)
    [config.h]
2026-09-09 chore(sensors): OneWire moves to D1 (perm wiring)
    T2 -> D1 per the final layout; D1 hardware UART noted off-limits for the
    future A02YYUW (use another Serial). Doc updated.
2026-09-09 fix(dosing): pH-Down = D13, spare = D12 — verified at the panel
    Panel truth 2026-09-09: A=D10, B=D11, pH-Down=D13 (reverts the D12
    correction; D12 is the spare).
    [config.h]
2026-09-09 fix(dosing): move pump signals back to bench-proven D4-D7 block
    The 2026-09-09 perm-wiring move to D10-D13 left only ch2 (D10) working:
    metering every terminal showed D11, D12 and D13 stuck at ~3.3 V with no
    servo frames - those pins have no mbed PwmOut timer route on the GIGA.
    Re-land all four channels on the bench-verified block, 1:1 with the
    original bench layout: ch1 pH-Down=D4, ch2 A=D5, ch3 B=D6, ch4 spare=D7.
    Documents the pin-capability finding in docs/dosing/dfr0523.md.
    Version 1.3.5.
    [config.h]
2026-09-09 fix(dosing): pin map as-landed by owner - ch1 pH=D6, ch2 A=D4, ch3 B=D5
    [config.h]
2026-09-09 docs(dosing): 2026-09-09 recalibration on final wiring + tube runs
    Full-speed: ch1 0.48 (was 0.73), ch2 0.66 (was 0.50), ch3 0.60 (held).
    Slow (speed 50): ch1 0.11, ch2 0.24, ch3 0.11. Perm plumbing shifted the
    constants hard, especially at low speed - rule added: recalibrate after
    any tube or routing change. Also notes short-dose transient losses.
2026-09-09 fix(sensors): EC signal on A2 per perm wiring (was A0)
    Perm wiring landed the TDS green on A2; firmware still read the floating
    A0 and published a flat phantom 0.15 mS/cm. Found during the #289 EC
    recalibration (probe in 1413 uS/cm fluid, reading would not move).
    Version 1.3.6.
    [config.h]
2026-09-09 fix(sensors): EC recalibration post-Cat5e - K 0.9745 -> 0.7692
    1413 uS/cm standard read a stable 1.79 mS/cm with the old K on the new
    A2 perm wiring (26.2 C, no settle drift). 21% shift = the new cable run.
    Version 1.3.7.
2026-09-09 fix(sensors): pH recalibration post-Cat5e - anchors 1.529/2.074 V
    Two-point recal on the perm wiring (buffers 7.00/4.00, second pass,
    26.1 C): slope unchanged at 0.1817 V/pH, ~0.03 V offset drift vs
    2026-08-28. Validated against 10.01 buffer: 0.979 V vs 0.982 predicted.
    Version 1.3.8.
2026-09-10 feat(controller): #278 Demeter — the k3s autodosing brain (pH-Down + Nutrients A/B)
    Adds controller/, a small Python service that closes the loop the
    monitoring-first phase left open: it watches pomona/water/# on the platform
    broker and corrects chemistry with the calibrated DFR0523 pumps, inside the
    same hard rails the interim Tethys agent operated under (card #224 remains
    the design of record):
    - pH > 7.0 -> 1 ml pH-Down full speed; 6.5 < pH <= 7.0 -> 0.5 ml slow;
    acid hard cap 4 ml per rolling 24 h (cap hit -> alert, never a dose)
    - EC < 0.7 -> 5 ml Nutrient A, 2 min, 5 ml Nutrient B (never simultaneous),
    max once per 24 h
    - confirm >= 10 min, 60 min lockout after ANY dose (foreign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
2026-09-10 feat(controller): #278 Demeter self-learning brain — Bayesian dosing + Kalman pH
    Two config rails (adaptive.enabled, adaptive.ph_max_single_dose_ml);
    everything else is learned from the reservoir and persisted in the
    retained ledger (v2, v1 still loads):
    - Model A: Bayesian linear regression drop = k*ml - b with a Gaussian
    posterior; dose sized so the posterior mean lands on the aim and the
    97.5% upper predictive drop keeps pH >= ph_tol_low. Uncertainty grows
    with ml^2, so extrapolation is penalised by the model itself.
    - Model B: Kalman local linear trend on pH with online noise estimation;
    gives the pre-dose level, the post-dose trough (true dose effect), the
    settle time (dyna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
2026-09-10 refactor(controller): #278 move Demeter to its own repo github.com/jellebens/demeter
    controller/ is extracted (git subtree split, history preserved) into the
    private repo jellebens/demeter; this repo keeps the firmware, the MQTT topic
    contract (docs/mqtt.md) and the DFR0523 calibration Demeter relies on.
    README and docs/mqtt.md point at the new home; nothing deployed changes
    (the image stays jellebens/pomona-demeter, deployed by gitops
    landingzones/pomona).
2026-09-11 docs(mqtt): #278 pomona/pump/power — HA-published plug watts, Demeter's mixing evidence (ADR-0005)
2026-09-11 docs(adr): #290 ADR-0001 — every pomona topic archived in InfluxDB forever; mqtt.md archive contract
    Starts the pomona docs/adr series (demeter/jupiter convention). docs/mqtt.md
    gains an Archive section mapping every topic to its InfluxDB measurement and
    documents the previously undocumented live topics (water/ph_raw_v,
    unit/i2c_scan, pump/override, control/mode). Platform decision: gitops
    ADR-0002.
2026-09-12 feat(firmware): #295 the v2 wire demeter/pomona-0001/… (demeter ADR-0008) + the #224 dosing contract — 2.0.0
    BREAKING: every topic moves under demeter/pomona-0001/ (tele/<zone>/<metric>,
    sys/status|meta|health|diag|ota, actuator/pump|light/state|reason|set,
    desired, dose/request|result); the unit connects as its own broker user
    unit-pomona-0001. sys/meta announces type, node, fw_version, contract 2,
    sensors, actuators, reservoir_l and every doser's calibration + caps.
    dose/request {id, reagent, ml, rate} is converted with the node's OWN
    calibration (PomonaCalibration DOSER_CAL) and checked against the node's OWN
    rails (per-command and rolling 24 h ml caps, one channel at a time, a 60 s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
    [config.h, dosing.cpp, dosing.h, network.cpp]
2026-09-12 feat(firmware): #297 the topic root is ceres/ (ADR-0012: Demeter became Ceres) — 2.1.0
    Every v2 topic is ceres/pomona-0001/…; the controller is Vertumnus
    (vertumnus-pomona-0001), the config service Annona. 2.0.0 was never flashed.
    Compiles clean (arduino-cli 1.5.1, mbed_giga 4.6.0; 750,700 B flash).
2026-09-13 feat(dosing): 2.2.0 — echo the request's traceparent in every dose/result (ceres card #302)
    A dose/request may carry a W3C traceparent; refusals at request time and the
    done ack echo it unchanged (opaque string). Event buffer 224 -> 320 bytes so an
    ack with the 55-char value never truncates. Compiles (arduino-cli, mbed_giga
    4.6.0): 750,956 B flash. Drops the stray .rel297b.sh scratch script.
2026-09-15 feat(display): home screen — water temp / EC / pH, air temp / humidity, tank-level placeholder
    Six tiles in two rows of three replace the nine-tile grid: water temp, EC
    and pH on top; air temp, humidity and a dimmed "tank level" placeholder
    below. Pressure, lux, the Grove level % and the probe status word leave
    the screen (still published on MQTT; the probe still drives the pump
    interlock). The placeholder waits for the continuous level sensor
    (#270 / #283). Unused setInt() removed so the build stays warning-free.
    Compiles clean for arduino:mbed_giga:giga (arduino-cli 1.5.1):
    750,468 B flash (38%), 139,872 B RAM (26%). Not flashed.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
    [display.cpp, display.h]
2026-09-15 chore(version): 2.3.0 — minor bump for the home screen (#102); changelog
    Set by hand like 2.0.0–2.2.0: the 2.x line is not on the tower yet and goes there
    together in the maintenance window of ceres card #295 item 7 (deploy with -Bump none).
2026-09-15 feat(agents): pomona-release subagent + cross-session release lock
    Codifies the full pomona-0001 change-and-release runbook we ran by hand on
    2026-09-15 (firmware edit + build -> OTA image -> stage on the ceres-firmware
    share -> record on Annona -> drive the flash -> release the dependent gitops
    change), with every owner-gated STOP point (merges, power cycle, actuator/pump,
    credential ops) and the gotchas found the hard way: the same-version OTA guard,
    the GIGA vs Envoy-gateway download failure, the DS918 slave zone-serial trap,
    the OTA remount begin(-3) bug, and the broker credential mismatch.
    The corruption on 2026-09-15 came from two sessions racing the same flow. The
    agent serialises it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
2026-09-16 fix(dosing): ceres #315 bound one request, not the day — pH-Down 4 ml per command, 24 h cap removed
    2.3.0 carried the retired playbook caps (2 ml per command, 8 ml per 24 h) and
    refused every Ceres dose from 2026-09-15 17:01 (pH 8.5 in a day). Owner
    2026-09-16: the node limits one request only. DOSE_MAX_ML_PER_CMD pH-Down
    2.0 -> 4.0; DOSE_MAX_ML_PER_24H, the per-channel dose ring and the
    "over 24h cap" refusal are gone; sys/meta no longer announces max_ml_per_24h.
    Still enforced per request: known + calibrated reagent, one channel at a
    time, the 60 s run cap, the 10 s bench cap. Builds for arduino:mbed_giga:giga:
    750,148 B flash / 138,848 B RAM.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
    [config.h, dosing.cpp]
2026-10-09 fix(network): 2.3.2 — retry NTP every minute until it answers, not after 6 h
    The node asked NTP once at connect and then every 6 h, also after a failed attempt.
    With no clock the light is held off, so one lost packet at boot meant up to 6 h of a
    dark tower: on 2026-10-09 the tower was moved indoors, rebooted twice, missed its one
    attempt and held the light off from 12:41 CEST. A failed attempt is now retried after
    60 s, alternating pool.ntp.org and time.cloudflare.com, until one answers; the 6 h
    resync applies only after a success. 750,340 B flash (38 %), 26 % RAM, warning-free
    apart from the BH1750 notice.
    [config.h, network.cpp]
2026-10-09 feat(agents): the credential gate — check secrets.h against the running image before any build
    2.3.2 (2026-10-09) was built from a stale secrets.h: the node flashed, the broker refused
    unit-pomona-0001 (bad_username_or_password), and since the OTA trigger is MQTT-only no corrected
    image could reach it. .claude/scripts/check-secrets.sh checks that WIFI_PASS and MQTT_PASS occur in
    the binary of the image the node runs now (never printing a value); the pomona-release runbook makes
    it Phase 3 step 0, a failure is a STOP for the owner, and every flashed build dir is kept as the
    next reference. Against build-2.3.1 it exits 1 — it would have caught 2.3.2.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
2026-10-09 feat(sensors): the tank level from the A02YYUW ultrasonic (#270 / #283)
    - libraries/A02YYUW: non-blocking parser of the 9600-baud 0xFF/H/L/SUM frames,
    median of the last 7 good frames, -1 after 3 s of silence
    - sensor on Serial2 (TX -> D19), 3V3, RX floating; sensorsPoll() every loop()
    - calibration TANK_DIST_FULL_MM / TANK_DIST_EMPTY_MM (NAN until read on the tower)
    - MQTT: tele/water/level_distance_mm always; level_pct + volume_l once calibrated
    (level_pct now the ultrasonic's); sys/health level_sonic(_calibrated)
    - screen: the tank tile shows litres (bands 60 % / 30 %), the raw mm before calibration
    - docs: sensors/level-sonic.md (wiring + calibration), wiring pin map, mqtt topics
    Co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
2026-10-09 chore(version): 2.4.0 — the tank level from the A02YYUW ultrasonic (#283); changelog
2026-10-09 feat(sensors): the tank in litres from a measured fill table; double echoes dropped (#283)
    - the tank tapers: TANK_TABLE (13 points measured 2026-10-09, 0 L @ 248 mm .. 9.5 L @ 46 mm)
    + TANK_FULL_L 9.5 replace TANK_DIST_FULL/EMPTY_MM; libraries/A02YYUW/src/TankTable.h
    interpolates and clamps
    - A02YYUW: frames within 10 % (min 10 mm) of twice another frame are double echoes and
    dropped; window 7 -> 15 frames
    - UNIT_RESERVOIR_L 9.5 (full is 9.5 L: 10 L would sit near the 30 mm blind zone)
    - docs: level-sonic.md fill-table procedure + recorded table + the echo; mqtt.md; changelog
    [config.h, sensors.cpp, sensors.h]
2026-10-09 chore(version): 2.4.1 — the tank in litres from a measured fill table; double echoes dropped (#283)
2026-10-09 fix(sensors): the tank table for the lid-closed mount; the blind zone reads full; frame counters (#283)
    - TANK_TABLE shifted +36 mm: 10 L at 76 mm (lid closed, pump off) .. 0 L at 284 mm; full 10 L;
    UNIT_RESERVOIR_L 10
    - A02YYUW: a valid 1-29 mm frame counts as 30 mm (full) instead of being dropped; 0 mm stays
    "no echo" (a tilted sensor); resync only after a checksum failure (a 0 mm frame's checksum
    byte is 0xFF and was taken for a header)
    - sys/health level_sonic_frames {good, near, bad}
    - docs: level-sonic.md (table in force, blind zone, read with the pump off), mqtt.md, changelog
    [config.h, network.cpp, sensors.cpp, sensors.h]
2026-10-09 chore(version): 2.4.2 — the tank table for the lid-closed mount; the blind zone reads full (#283)
2026-10-11 fix(level): 2.4.3 — a tank reading is litres only when it is the water surface (#283)
    2.4.2 clamped every distance to the fill table's ends: the return water falling past the sensor
    during a pump run (33-53 mm) read "10 L", and a wet face (condensation over 25 C water) read
    240-720 mm, "0 L" for over a day, while the tank held ~9 L. tankJudge classifies each reading as
    splash (nearer than FULL by > 15 mm), no_echo (past EMPTY by > 20 mm), unsteady (6 sweeps / 30 s
    disagree by > 15 mm) or ok; only ok publishes level_pct/volume_l, sys/health carries
    level_sonic_state, the screen shows the state word. Host-tested on the tower's own readings;
    752,140 B flash (38 %), credential gate passed agai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
2026-10-16 feat(sensors): 2.4.4 — EC is read between pump runs (ceres ADR-0020)
    The EC probe reads the pump: with it running the un-isolated TDS board reads high (1.43 -> 1.81,
    1.63 -> 1.96 mS/cm), the step within seconds of each switch; pH, isolated, is unaffected. Ceres 0.28.0
    refuses an EC whose pump states disagree, so EC control had stopped. Until the probe gets an
    isolator, ec_ms_cm is taken only with the pump off for 2 min and held through the run (dropped after
    45 min; live until the first pump-off value after boot); ec_live_ms_cm publishes every sweep's raw
    reading, sys/health.ec_held says which. Host-tested on the 2026-10-15/16 pattern; 752,404 B flash
    (38 %); credential gate passed against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
2026-10-16 fix(level): 2.4.5 — the tank table for the remounted sensor (#283)
    The old mount heard something before the water: 87 mm steady (9.06 L) at ~5 L. Remounted and
    measured pump off with known volumes: 5.5 L = 110 mm, 7.5 L = 66, 8.0 L = 56, 9.0 L = 37 (~20 mm
    per litre). Those are the table's top; below 5.5 L the 2026-10-09 shape shifted -18 mm. 10 L would
    be in the blind zone at this mount, so 9.0 L is the top of the table. Credential gate passed
    against build-2.4.4.
2026-10-16 feat(level): 2.4.6 — the tank level is read between pump runs (#283)
    While the pump runs a litre or two is up in the tower and the surface is choppy (98-126 mm and
    no-echo spikes at 9 L), and it drains back for minutes after a stop (8.74 L a minute after a run,
    9.0 L after half an hour). The level (level_distance_mm, level_pct, volume_l) is now taken only once
    the pump has been off 5 min and held through the next run — the same hold as EC's (ec_hold.h),
    dropped after 45 min. level_distance_live_mm publishes every sweep's raw median;
    sys/health.level_held says which. Host-tested on the 2026-10-16 pattern; credential gate passed
    against build-2.4.5.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
2026-10-16 fix(control): 2.4.7 — after a boot the pump runs first
    The duty cycle started in its off phase at every boot, so a reboot added a whole off spell (15 min
    establishment, 45 day / 105 night established) on top of the downtime: two OTAs within 14 min on
    2026-10-16 left the pump off from 13:58 to ~14:27. Every boot now starts the cycle with a run, then
    the normal off spell; the pump is still off through setup, and the level interlock and an operator
    override still take precedence. Credential gate passed against build-2.4.6.
2026-10-19 fix(level): 2.4.8 — the tank level is live again (#283)
    Undoes 2.4.6's level hold: level_distance_mm, level_pct and volume_l are each
    sweep's reading again, pump on or off, so MQTT, Prometheus and the dashboards
    show what the A02YYUW reads. The hold showed a steady 30 mm / 9.00 L for two and
    a half days while every frame was `near` (the blind-zone floor, zero good
    frames). tankJudge still publishes no litres for an unsteady surface.
    level_distance_live_mm (now the same value) and sys/health.level_held (always
    false) stay so no reader breaks; the EC hold (2.4.4) is unchanged. Credential
    gate passed against build-2.4.7; compiles clean (752,548 bytes).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
2026-10-19 fix(level): 2.4.9 — a sensor pinned at its blind-zone floor says `near` (#283)
    tankJudge now returns Near for a reading at or under the A02YYUW's 30 mm floor
    (A02YYUW::MIN_MM; a blind-zone frame reads as 30 mm, so a median there means
    most frames were `near`). sys/health.level_sonic_state = near, level_distance_mm
    still publishes the raw value, and no level_pct / volume_l — the same as
    no_echo. At the 2.4.5 mount FULL (9.0 L) is 37 mm, within the 15 mm splash
    margin of the floor, so a pinned sensor passed as ok: 2026-10-16..19 every frame
    was `near` (zero good) and the node reported 30 mm / 9.00 L for 2.5 days.
    Credential gate passed against build-2.4.8; compiles clean (752,556 bytes).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
2026-10-20 fix(level): 2.4.10 — the tank table for the remounted sensor, 10 L = 36 mm (#283)
    The A02YYUW was remounted on 2026-10-19 with its transducer bosses clear of the lid; with exactly
    10 L in the tank it read 36 mm, which the 2.4.5 table called 9.0 L. From the owner's fill of
    2026-10-20 (pump off, settled): ~6.1 L = 88 mm, almost 4 L poured in, 10 L = 36 mm — ~13 mm/L near
    the top, as the 2026-10-09 fill measured; below 6.1 L that fill's shape shifted -33 mm. 10 L is
    FULL again, clear of the 30 mm floor.
